ib619/Group7_design_project/Energy_Subsystem/Integration with Control/notes.md

# How to rearrange test files

1. Script for testing battery charge and discharge, with power source connected
2. Script for testing battery charging with PV panels (KEY AIM)
3. Script for testing PV discharge to batteries
4. Script for testing battery discharge to load
