ib619/Group7_design_project/Command_Subsystem/README.md

# Command Subsystem

## Folder Structure
```
Command_Subsystem
│   └───README.md
│   └───server               
│   |   └───authen       
|   |   |   |   └───mosquitto.conf  
|   |   |   |   |   ...
|   |   └───database.py
|   |   └───mqtt_server.py
|   |   └───requirements.txt
|   |   └───start_server.sh
|   |   |   ... 
|   └───client  
|   |   └───package.json
|   |   └───src  
|   |   |   └───assets
|   |   |   |   └───home.svg
|   |   |   |   |   ...
|   |   |   └───components
|   |   |   |   └───Battery.js
|   |   |   |   |   ...
|   |   |   └───hooks
|   |   |   |   └───useToken.js
|   |   |   |   |   ...
|   |   |   └───pages
|   |   |   |   └───DiscretePage.js
|   |   |   |   |   ...
|   |   |   └───App.js
|   |   |   └───index.js
|   |   |   |   ...            
```
## How to setup up the MQTT broker locally (without authentication)
- If you're running MQTT broker on AWS you can skip this step
1. Install the mosquitto broker using your local package manager
2. In the `mosquitto.conf` file, add the following lines:

```
listener 1883
protocol mqtt
listener 8080
protocol websockets

allow_anonymous true
```
4. On mac, the config file is located at `/usr/local/etc/mosquitto/mosquitto.conf`
5. To start the local mosquitto broker with the config file run: `/usr/local/sbin/mosquitto -c /usr/local/etc/mosquitto/mosquitto.conf -v`
    - [path to mosquitto exe] -c [path to config file]

## How to run the frontend (react)
1. Install npm using your local package manager 
2. Run `npm install` to install all the required dependencies in the `client` directory
3. To start the web app `npm start`
    - This will start the development build for the client (react app)

## How to run production build (frontend)
1. `npm run build` to create `build` folder
2. `serve -s build` to view the webpage on your local network

## How to run the backend (python)
1. In the `server` directory, run `pip3 install -r requirements.txt`
2. To create the `.db` file, run `python3 database.py` in the `server` directory (this is only if you haven't already created the database)
3. To run the backend server, run `python3 mqtt_server.py` in the `server` directory
4. Can also run the script `./start_server.sh` in the `server` directory to set up the database and server
    - `chmod +x start_server.sh` first

## How to set up AWS server 
1. Create EC2 Ubuntu Server and open the following ports:
    - Custom TCP 8080 (Used for websockets with React, May not need to open this if React is on EC2 itself)
    - Cusom TCP 1883 (Used for MQTT)
    - SSH 22
2. Specify "Anywhere" for the Source so that connections can be made anywhere
3. After downloading the key-pair, run `chmod og-rwx [path to .pem file]` to change permissions
4. To ssh into the instance, run `ssh -i [path to key-pair] ubuntu@[ip address of server]
5. To setup the stuff, in the root directory
```
sudo apt update
[ clone the git repo ]
cd Group7_design_project/Command_Subsystem/server
sudo curl -sSL https://get.docker.com/ | sh
```
6. Then run `sudo docker build . -t mars_server:1.0 --file Dockerfile` (also run this whenever the Dockerfile changes)
7. Run this command to start up the docker image and link docker ports to server ports
`sudo docker run -it --rm -p 0.0.0.0:1883:1883 -p 0.0.0.0:8080:8080/tcp mars_server:1.0`

## How to use the webpage 
1. On the Login page, enter the IP address of your MQTT broker, followed by a username and password pair.
    - If not using AWS server (Ubuntu), can be any username and password
    - If using AWS server, the list of valid usernames and passwords are shown below
    - At any point in time, only 1 user of a certain username and password pair can be connected to the web interface

Username | Password| Permissions
--- | --- | ---
admin | marsrover | full access
siting | password | read access 
siyu | password | read access 
igor | password | read access 
joshua | password | read access 
tah | password | read access 
yanni | password | read access 

2. On the home page, clicking on any of the links on the navigation bar will bring you to another page.
3. Clicking on the battery icon will create a pop-up screen that displays more in-depth information about the individual cells.
4. Scrolling and panning can be done on the map but only to a certain extent
5. After logging in once, login details will be saved and you won't be prompted to log in again
6. If you wish to change any of the log in details, use the `Log Out` button to return to the Login page
### Details
1. Things to send back to ESP32
    - drive/discrete: discrete mode instructions 
    - drive/t2c: t2c mode instructions
    - reset: reset rover to 0,0 / emergency stop
    - battery/recalibrate: tell battery to recalibrate

2. Things to receive from ESP32:
    - position/update: rover's current position
    - obstacle/result: 5 most recent obtsacle data
    - rover/status: rover status / remaining range
    - battery/status: battery soh / soc / state
    - path: past positions to map out path taken by rover
    - rssi: signal strength

3. Backend/Database:
    - Backend database using SQLite hosted on AWS using Docker containers
    - MQTT protocol for communication between ESP32, backend and frontend
    - obstacle/update: stream of detected obstacle position, keeps track of recent ones and stores in a db
    - position/update: stores positions in a db to be sent on path 

## Testing Procedure
### Testing the server
1. In the `server` folder, run `python3 mqtt_server.py` then run `python3 test_mqtt_server.py` in a separate terminal
2. Check the test script terminal for outputs to make sure the result is as expected

### Testing the database 
1. Run `python3 test_database.py` and check the terminal outputs to ensure that the results are correct
