ib619/Group7_design_project/Energy_Subsystem/Drive_Data/drivepwr.jpg

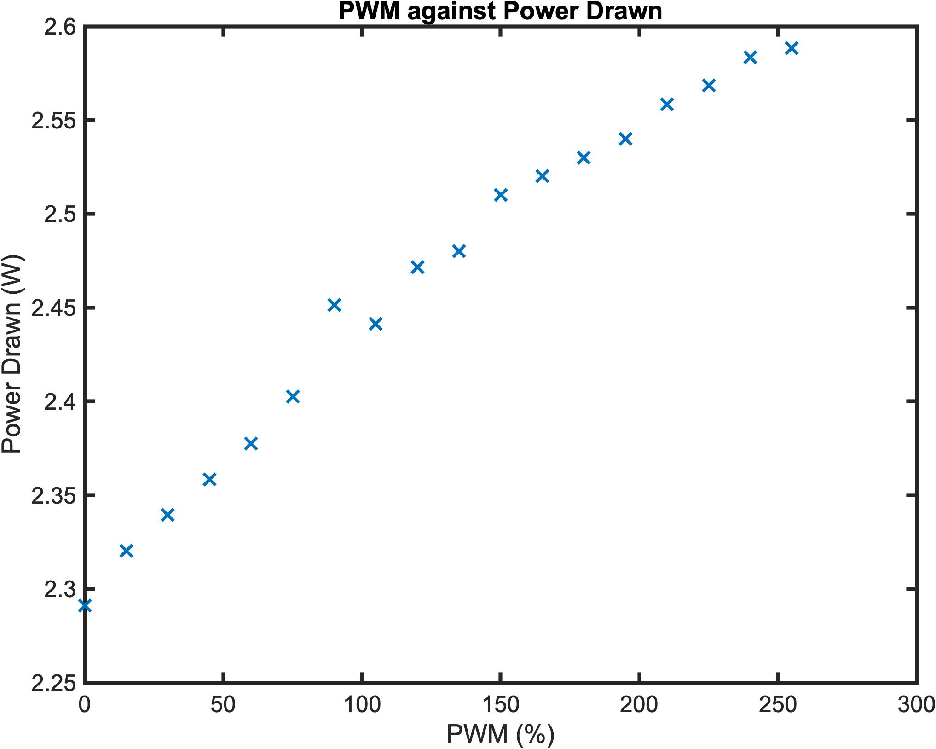
Energy_Subsystem/Drive_Data/drivepwr.jpg
