ib619/Group7_design_project/Energy_Subsystem/Images/Cell Balancing.png

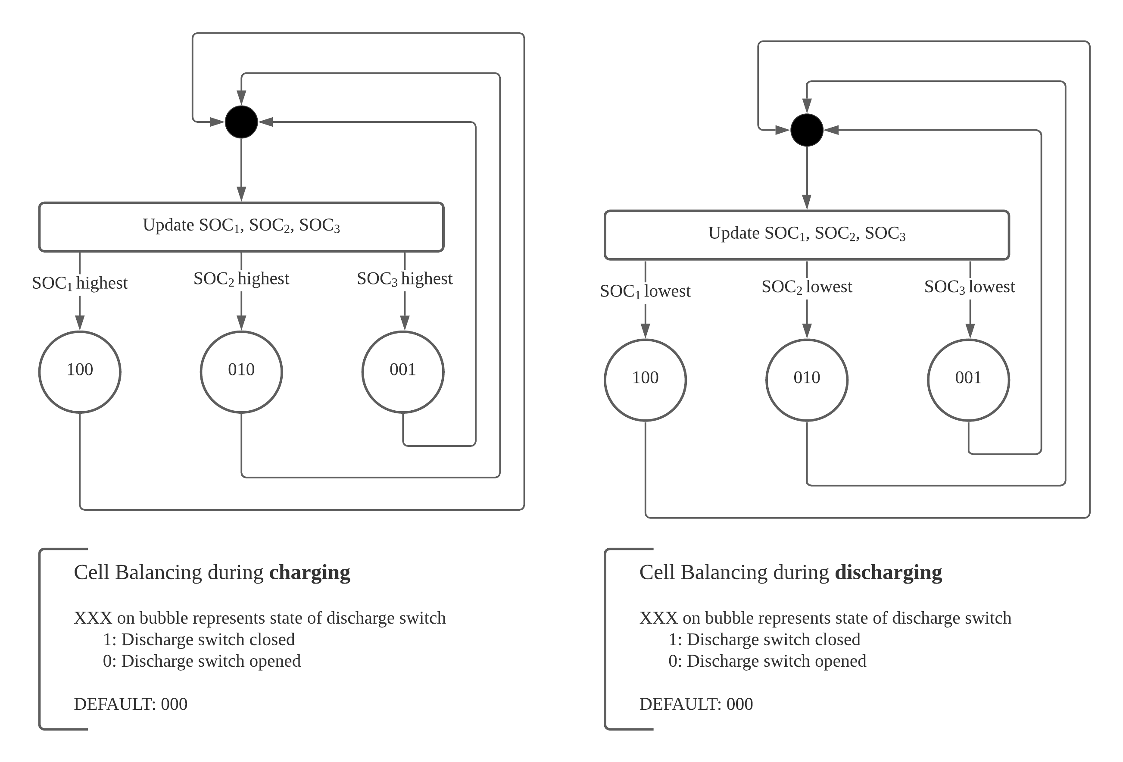
Energy_Subsystem/Images/Cell Balancing.png
