ib619/Group7_design_project/Energy_Subsystem/Images/cv_curve.jpg

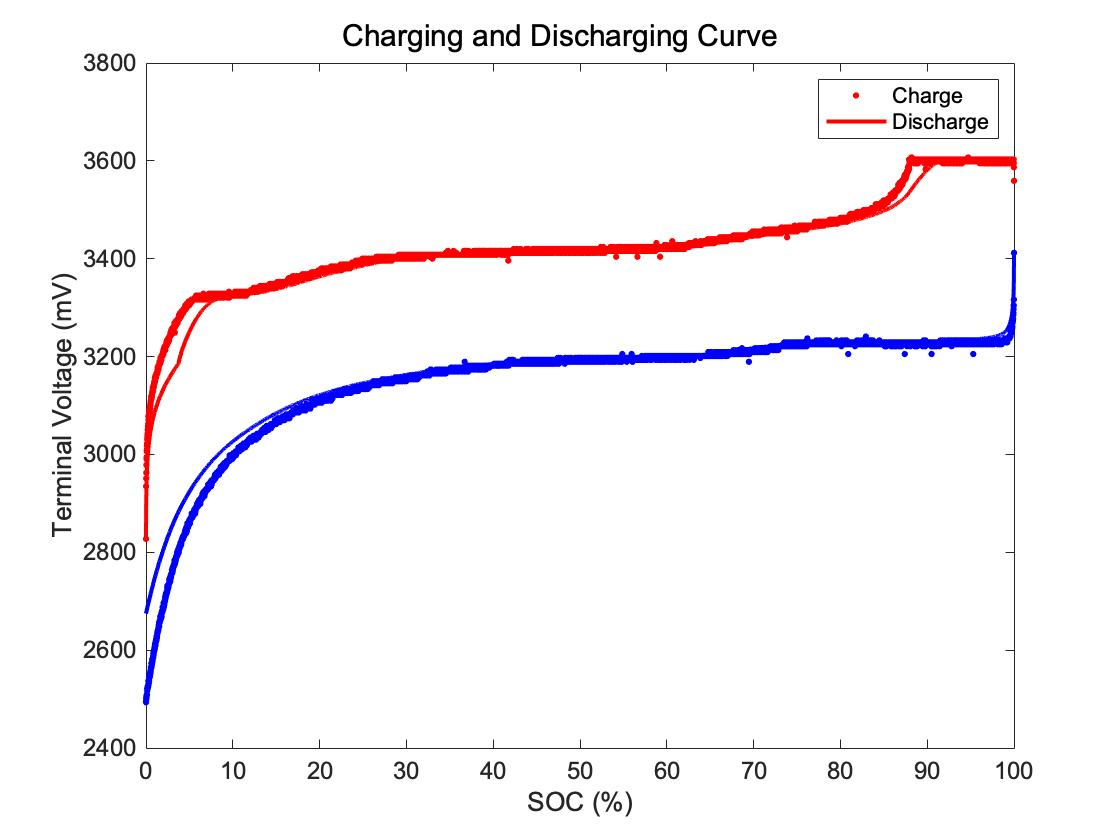
Energy_Subsystem/Images/cv_curve.jpg
