ib619/Group7_design_project/Energy_Subsystem/Images/Energy State Diagram.png

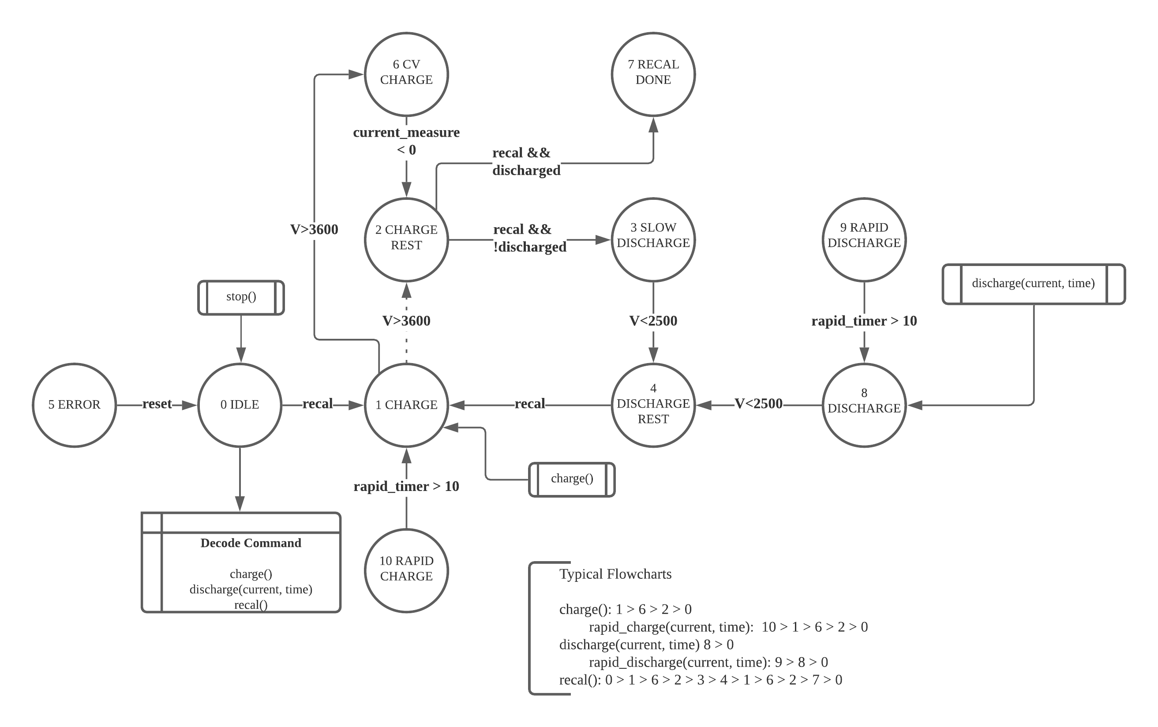
Energy_Subsystem/Images/Energy State Diagram.png
