ib619/Group7_design_project/Energy_Subsystem/Images/IC_Increment_Comparison.jpg

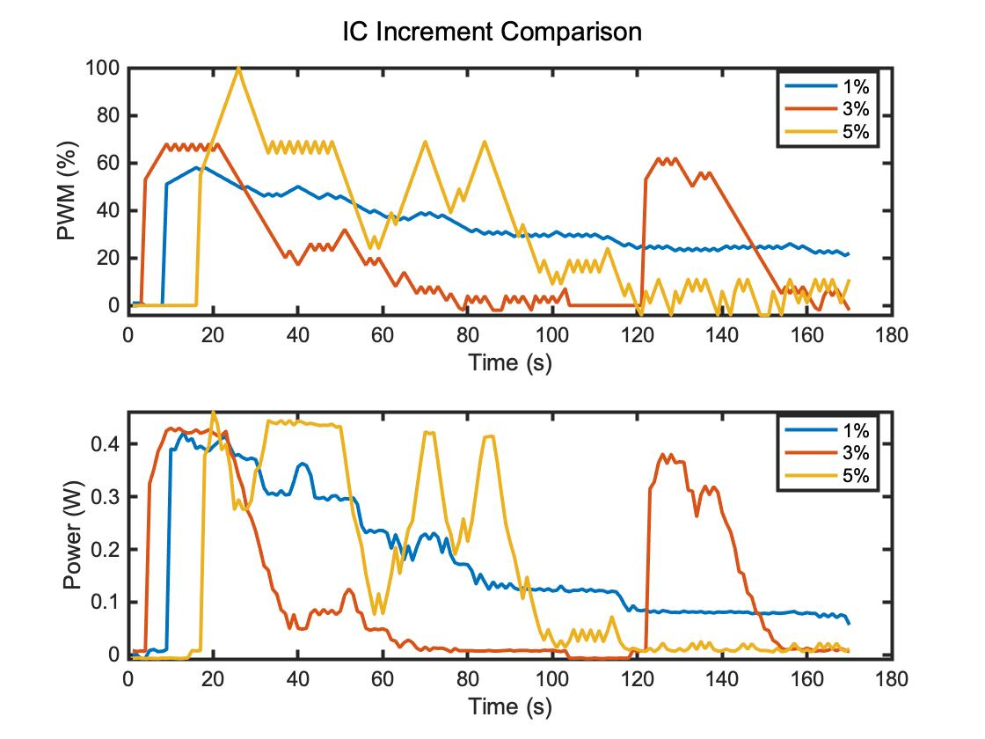
Energy_Subsystem/Images/IC_Increment_Comparison.jpg
