ib619/Group7_design_project/Energy_Subsystem/Images/PnO.png

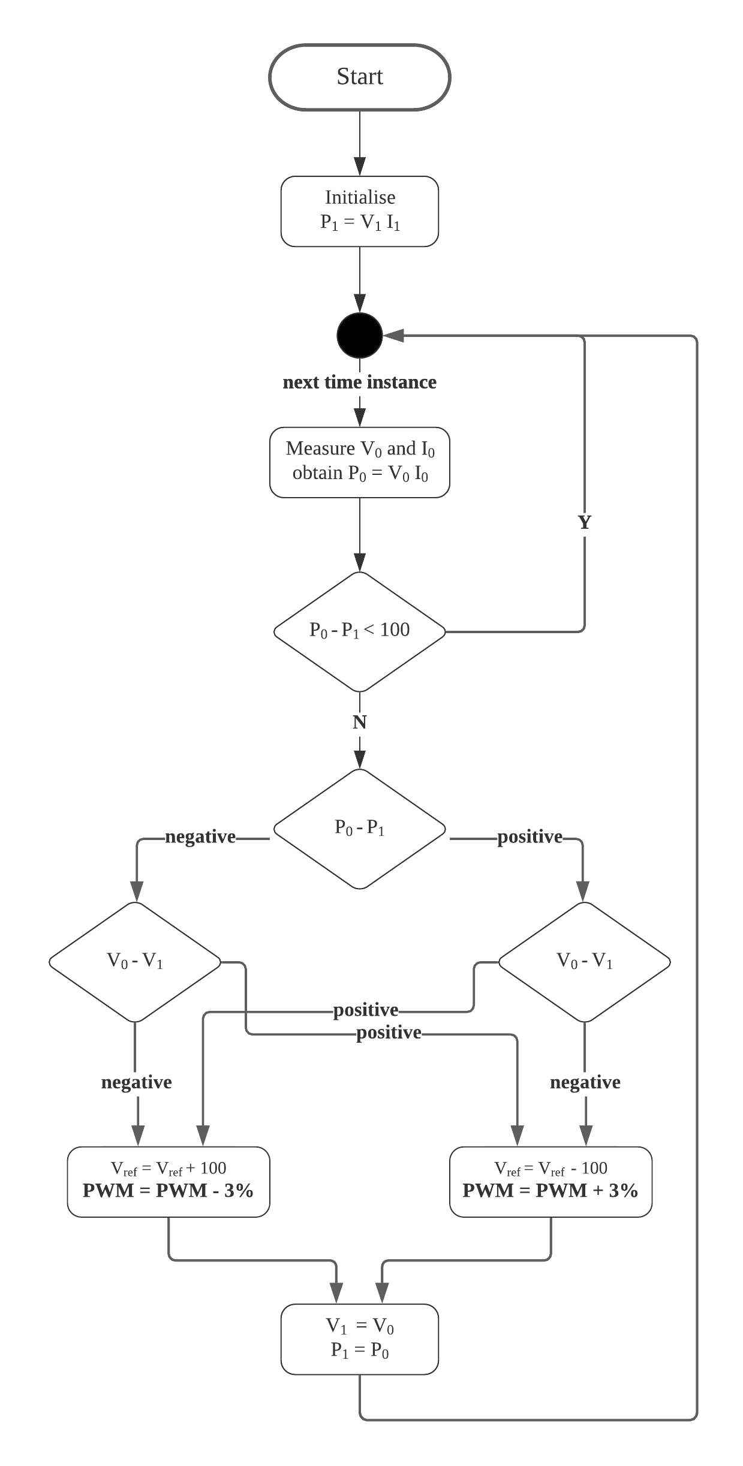
Energy_Subsystem/Images/PnO.png
