ib619/Group7_design_project/Energy_Subsystem/Images/PV_1_PWM.jpg

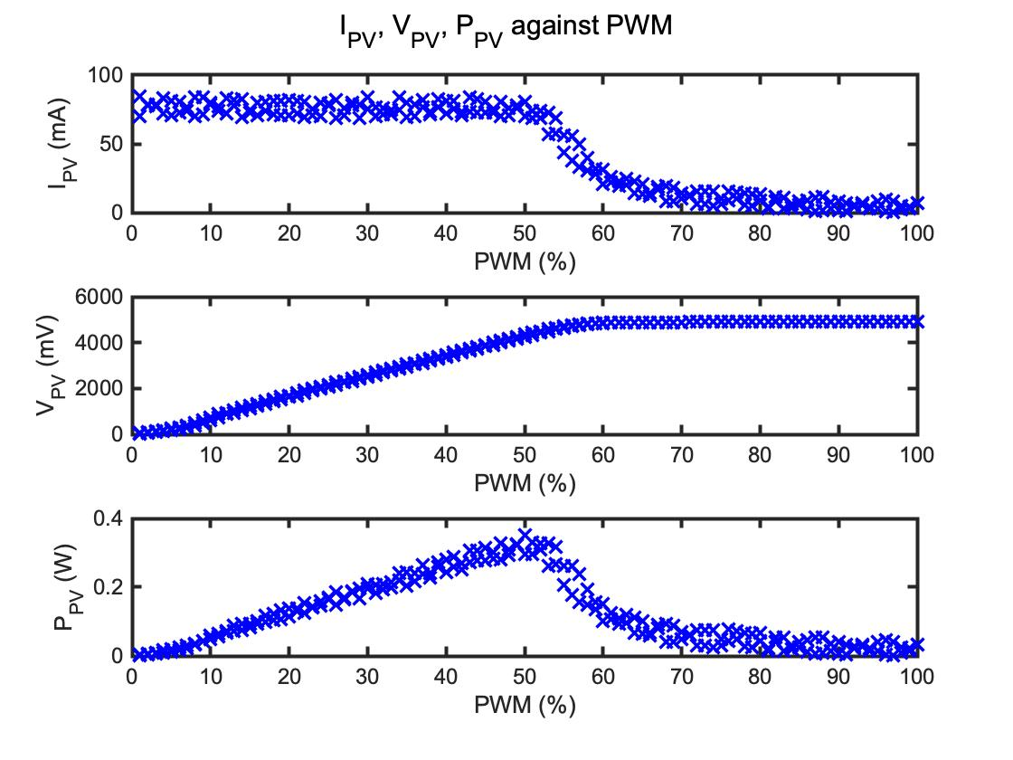
Energy_Subsystem/Images/PV_1_PWM.jpg
