ib619/Group7_design_project/Energy_Subsystem/Images/SoC Estimation Algorithm.png

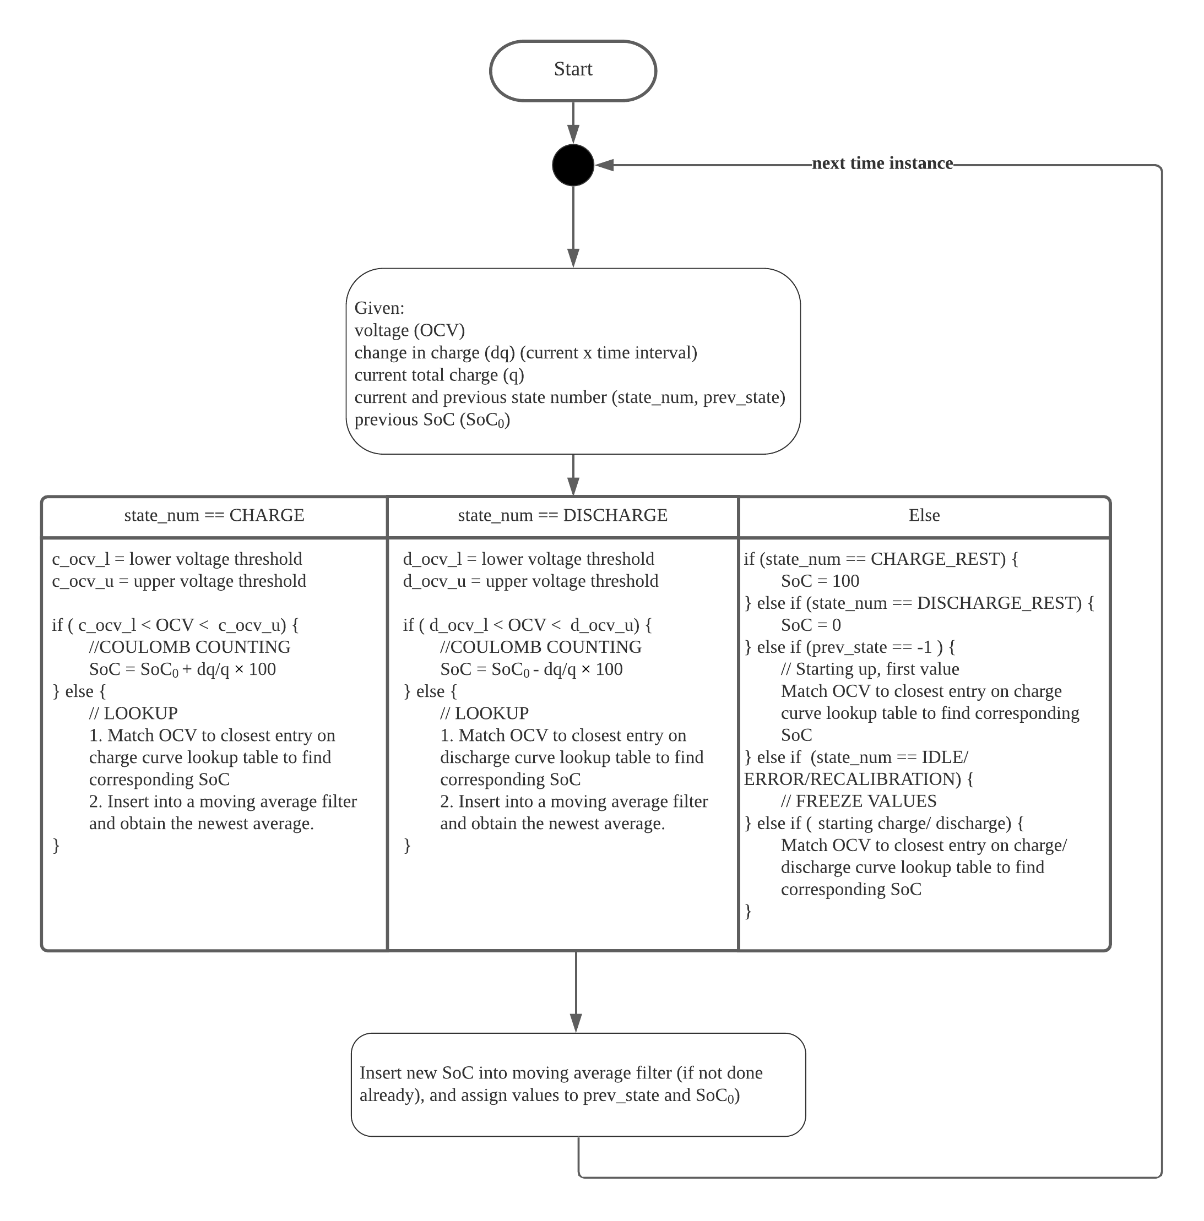
Energy_Subsystem/Images/SoC Estimation Algorithm.png
