ib619/Group7_design_project/Energy_Subsystem/Images/wall_discharge_SoC_ideal.jpg

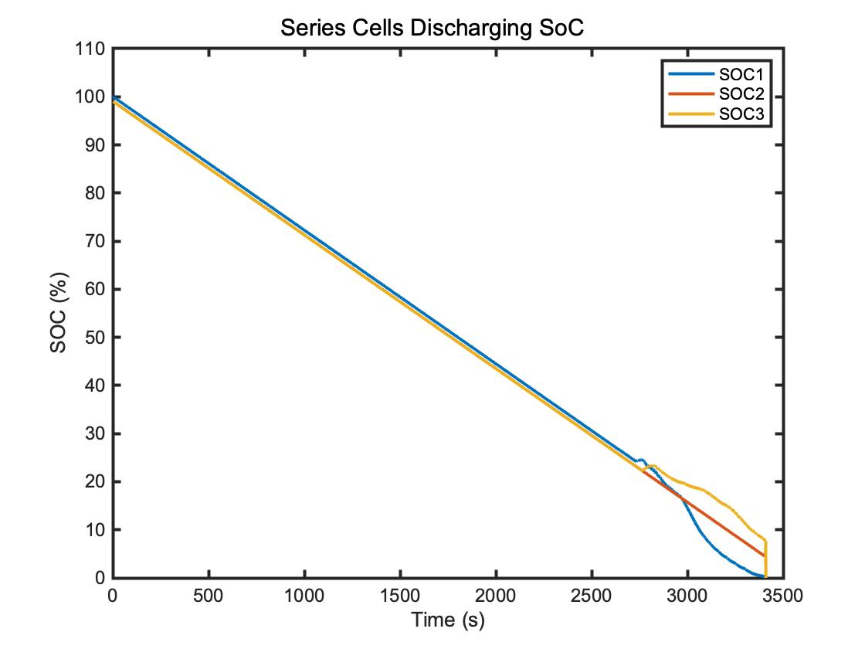
Energy_Subsystem/Images/wall_discharge_SoC_ideal.jpg
