ib619/Group7_design_project/(list of files, cad)

Other CAD files:
Vision_Subsystem/DE10_LITE_D8M_VIP_16/stp1.stp
