ib619/Group7_design_project/Energy_Subsystem/Test Scripts/Wall_Charge/Test1/serial1.rtf

Initializing SD card...
Wiring is correct and a card is present.
3380.19,3392.12,3384.17,100.00
3252.94,3256.92,3248.96,98.99
3252.94,3244.99,3248.96,97.98
3248.96,3244.99,3244.99,96.97
3248.96,3244.99,3244.99,95.96
3248.96,3244.99,3248.96,94.95
3244.99,3244.99,3244.99,93.94
3244.99,3244.99,3244.99,92.93
3248.96,3241.01,3244.99,91.92
3248.96,3241.01,3244.99,90.91
3244.99,3241.01,3244.99,89.90
3244.99,3241.01,3244.99,88.89
3241.01,3241.01,3244.99,87.88
3244.99,3241.01,3241.01,86.87
3241.01,3241.01,3241.01,85.86
3241.01,3237.03,3241.01,84.85
3241.01,3237.03,3237.03,83.84
3241.01,3237.03,3241.01,82.83
3237.03,3237.03,3237.03,81.82
3233.06,3229.08,3237.03,80.81
3229.08,3229.08,3237.03,79.80
3225.10,3233.06,3229.08,78.79
3225.10,3233.06,3233.06,77.78
3221.13,3229.08,3225.10,76.77
3221.13,3229.08,3225.10,75.76
3221.13,3225.10,3221.13,74.75
3217.15,3221.13,3221.13,73.74
3213.17,3221.13,3221.13,72.73
3213.17,3217.15,3217.15,71.72
3217.15,3217.15,3217.15,70.71
3217.15,3213.17,3209.20,69.70
3217.15,3213.17,3209.20,68.69
3213.17,3205.22,3213.17,67.68
3217.15,3209.20,3209.20,66.67
3217.15,3205.22,3209.20,65.66
3217.15,3201.24,3209.20,64.65
3217.15,3209.20,3209.20,63.64
3217.15,3201.24,3205.22,62.63
3213.17,3201.24,3209.20,61.62
3217.15,3201.24,3209.20,60.61
3217.15,3201.24,3213.17,59.60
3213.17,3197.27,3205.22,58.59
3213.17,3197.27,3205.22,57.58
3213.17,3197.27,3205.22,56.57
3213.17,3197.27,3205.22,55.56
3209.20,3189.31,3197.27,54.55
3209.20,3197.27,3201.24,53.54
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
Looked up charge table
Not moving average
1,3356.33,3328.50,3304.64,24.24,1.15,6.16,1793.00,2000.50,1921.75
1,3356.33,3328.50,3304.64,-490.00,-488.40,1,0,1
Looked up charge table
Not moving average
1,3352.36,3328.50,3304.64,21.21,1.13,6.14,1793.00,2000.50,1921.75
1,3352.36,3328.50,3304.64,-490.00,-491.60,1,0,1
Looked up charge table
Not moving average
1,3352.36,3328.50,3304.64,21.21,1.10,6.11,1793.00,2000.50,1921.75
1,3352.36,3328.50,3304.64,-490.00,-559.70,1,0,1
Looked up charge table
Not moving average
1,3352.36,3328.50,3304.64,21.21,1.08,6.08,1793.00,2000.50,1921.75
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
