ib619/Group7_design_project/Vision_Subsystem/testing/gaussian_filter/db/gaussian_filter_tb.lpc.html

Hierarchy | Input | Constant Input | Unused Input | Floating Input | Output | Constant Output | Unused Output | Floating Output | Bidir | Constant Bidir | Unused Bidir | Input only Bidir | Output only Bidir
lbuff3|ALTSHIFT_TAPS_component|auto_generated|cntr3 | 4 | 0 | 0 | 0 | 1 | 0 | 0 | 0 | 0 | 0 | 0 | 0 | 0
lbuff3|ALTSHIFT_TAPS_component|auto_generated|cntr1|cmpr7 | 6 | 0 | 0 | 0 | 1 | 0 | 0 | 0 | 0 | 0 | 0 | 0 | 0
lbuff3|ALTSHIFT_TAPS_component|auto_generated|cntr1 | 2 | 0 | 0 | 0 | 3 | 0 | 0 | 0 | 0 | 0 | 0 | 0 | 0
lbuff3|ALTSHIFT_TAPS_component|auto_generated|altsyncram2 | 42 | 1 | 0 | 1 | 32 | 1 | 1 | 1 | 0 | 0 | 0 | 0 | 0
lbuff3|ALTSHIFT_TAPS_component|auto_generated | 11 | 0 | 0 | 0 | 40 | 0 | 0 | 0 | 0 | 0 | 0 | 0 | 0
lbuff3 | 11 | 0 | 0 | 0 | 40 | 0 | 0 | 0 | 0 | 0 | 0 | 0 | 0
