ib619/Group7_design_project/Vision_Subsystem/testing/morph_filter/dilation/db/dilation_filter_tb.lpc.html

Hierarchy | Input | Constant Input | Unused Input | Floating Input | Output | Constant Output | Unused Output | Floating Output | Bidir | Constant Bidir | Unused Bidir | Input only Bidir | Output only Bidir
lbuff|ALTSHIFT_TAPS_component|auto_generated|cntr3 | 4 | 0 | 0 | 0 | 1 | 0 | 0 | 0 | 0 | 0 | 0 | 0 | 0
lbuff|ALTSHIFT_TAPS_component|auto_generated|cntr1|cmpr7 | 6 | 0 | 0 | 0 | 1 | 0 | 0 | 0 | 0 | 0 | 0 | 0 | 0
lbuff|ALTSHIFT_TAPS_component|auto_generated|cntr1 | 2 | 0 | 0 | 0 | 3 | 0 | 0 | 0 | 0 | 0 | 0 | 0 | 0
lbuff|ALTSHIFT_TAPS_component|auto_generated|altsyncram2 | 12 | 1 | 0 | 1 | 2 | 1 | 1 | 1 | 0 | 0 | 0 | 0 | 0
lbuff|ALTSHIFT_TAPS_component|auto_generated | 4 | 0 | 0 | 0 | 3 | 0 | 0 | 0 | 0 | 0 | 0 | 0 | 0
lbuff | 4 | 0 | 0 | 0 | 2 | 0 | 0 | 0 | 0 | 0 | 0 | 0 | 0
