ib619/Group7_design_project/Vision_Subsystem/testing/colour_threshold/rgb_to_hsv_tb/db/rgb_to_hsv_tb.lpc.html

Hierarchy | Input | Constant Input | Unused Input | Floating Input | Output | Constant Output | Unused Output | Floating Output | Bidir | Constant Bidir | Unused Bidir | Input only Bidir | Output only Bidir
divide_s|LPM_DIVIDE_component|auto_generated|divider|divider|add_sub_1 | 4 | 0 | 0 | 0 | 3 | 0 | 0 | 0 | 0 | 0 | 0 | 0 | 0
divide_s|LPM_DIVIDE_component|auto_generated|divider|divider|add_sub_0 | 2 | 0 | 0 | 0 | 2 | 0 | 0 | 0 | 0 | 0 | 0 | 0 | 0
divide_s|LPM_DIVIDE_component|auto_generated|divider|divider | 27 | 0 | 0 | 0 | 24 | 0 | 0 | 0 | 0 | 0 | 0 | 0 | 0
divide_s|LPM_DIVIDE_component|auto_generated|divider | 27 | 0 | 0 | 0 | 24 | 0 | 0 | 0 | 0 | 0 | 0 | 0 | 0
divide_s|LPM_DIVIDE_component|auto_generated | 27 | 0 | 0 | 0 | 24 | 0 | 0 | 0 | 0 | 0 | 0 | 0 | 0
divide_s | 27 | 8 | 0 | 8 | 16 | 8 | 8 | 8 | 0 | 0 | 0 | 0 | 0
divide_h|LPM_DIVIDE_component|auto_generated|divider|divider|add_sub_1 | 4 | 0 | 0 | 0 | 3 | 0 | 0 | 0 | 0 | 0 | 0 | 0 | 0
divide_h|LPM_DIVIDE_component|auto_generated|divider|divider|add_sub_0 | 2 | 0 | 0 | 0 | 2 | 0 | 0 | 0 | 0 | 0 | 0 | 0 | 0
divide_h|LPM_DIVIDE_component|auto_generated|divider|divider | 25 | 0 | 0 | 0 | 30 | 0 | 0 | 0 | 0 | 0 | 0 | 0 | 0
divide_h|LPM_DIVIDE_component|auto_generated|divider | 25 | 0 | 0 | 0 | 22 | 0 | 0 | 0 | 0 | 0 | 0 | 0 | 0
divide_h|LPM_DIVIDE_component|auto_generated | 25 | 0 | 0 | 0 | 22 | 0 | 0 | 0 | 0 | 0 | 0 | 0 | 0
divide_h | 25 | 0 | 0 | 0 | 14 | 0 | 0 | 0 | 0 | 0 | 0 | 0 | 0
