ib619/Group7_design_project/Vision_Subsystem/testing/perspective_transform/perspective_transform_tb/db/perspective_transform_tb.lpc.html

Hierarchy | Input | Constant Input | Unused Input | Floating Input | Output | Constant Output | Unused Output | Floating Output | Bidir | Constant Bidir | Unused Bidir | Input only Bidir | Output only Bidir
dy|LPM_DIVIDE_component|auto_generated|divider|divider|add_sub_1 | 4 | 0 | 0 | 0 | 3 | 0 | 0 | 0 | 0 | 0 | 0 | 0 | 0
dy|LPM_DIVIDE_component|auto_generated|divider|divider|add_sub_0 | 2 | 0 | 0 | 0 | 2 | 0 | 0 | 0 | 0 | 0 | 0 | 0 | 0
dy|LPM_DIVIDE_component|auto_generated|divider|divider | 58 | 0 | 0 | 0 | 84 | 0 | 0 | 0 | 0 | 0 | 0 | 0 | 0
dy|LPM_DIVIDE_component|auto_generated|divider | 58 | 0 | 0 | 0 | 56 | 0 | 0 | 0 | 0 | 0 | 0 | 0 | 0
dy|LPM_DIVIDE_component|auto_generated | 58 | 0 | 0 | 0 | 56 | 0 | 0 | 0 | 0 | 0 | 0 | 0 | 0
dy | 58 | 0 | 0 | 0 | 28 | 0 | 0 | 0 | 0 | 0 | 0 | 0 | 0
dx|LPM_DIVIDE_component|auto_generated|divider|divider|add_sub_1 | 4 | 0 | 0 | 0 | 3 | 0 | 0 | 0 | 0 | 0 | 0 | 0 | 0
dx|LPM_DIVIDE_component|auto_generated|divider|divider|add_sub_0 | 2 | 0 | 0 | 0 | 2 | 0 | 0 | 0 | 0 | 0 | 0 | 0 | 0
dx|LPM_DIVIDE_component|auto_generated|divider|divider | 58 | 0 | 0 | 0 | 84 | 0 | 0 | 0 | 0 | 0 | 0 | 0 | 0
dx|LPM_DIVIDE_component|auto_generated|divider | 58 | 0 | 0 | 0 | 56 | 0 | 0 | 0 | 0 | 0 | 0 | 0 | 0
dx|LPM_DIVIDE_component|auto_generated | 58 | 0 | 0 | 0 | 56 | 0 | 0 | 0 | 0 | 0 | 0 | 0 | 0
dx | 58 | 0 | 0 | 0 | 28 | 0 | 0 | 0 | 0 | 0 | 0 | 0 | 0
