ib619/Group7_design_project/Drive_Subsystem/test_setup.png

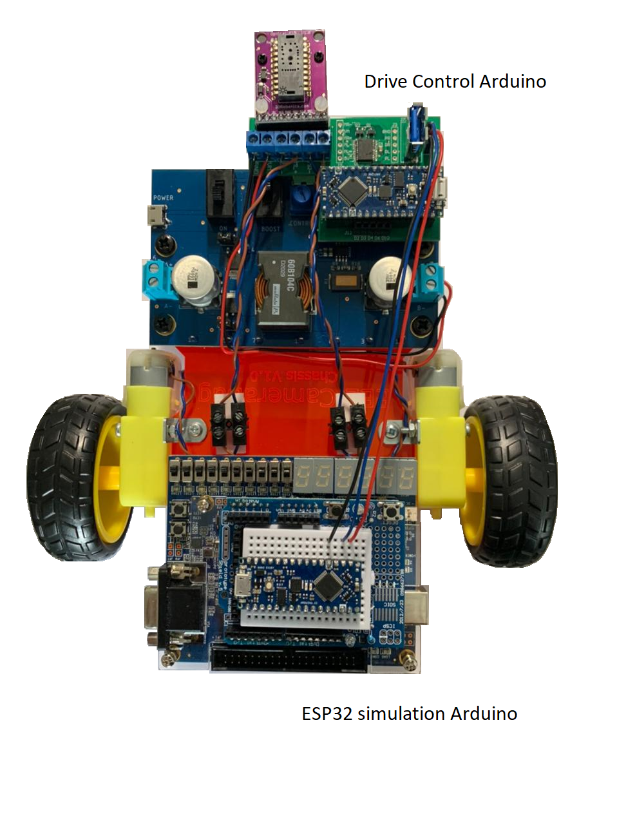
Drive_Subsystem/test_setup.png
