ib619/Group7_design_project/Energy_Subsystem/Images/cv_characteristic.jpg

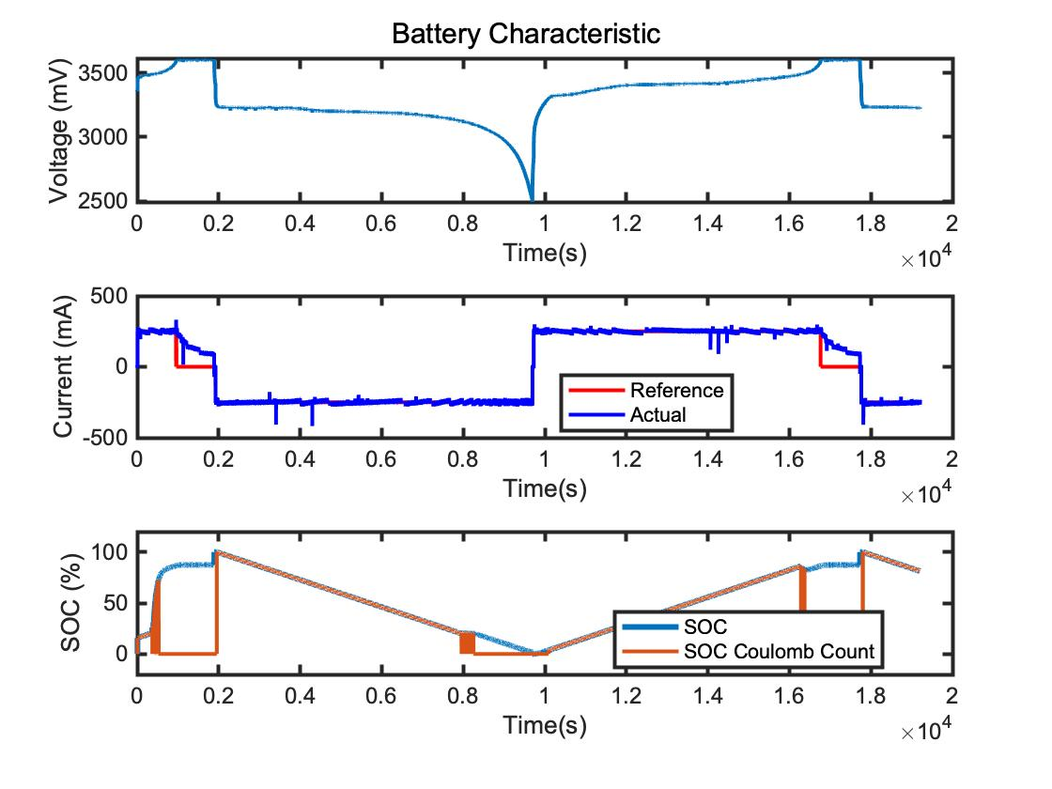
Energy_Subsystem/Images/cv_characteristic.jpg
