ib619/Group7_design_project/Energy_Subsystem/Images/normal_characteristic.jpg

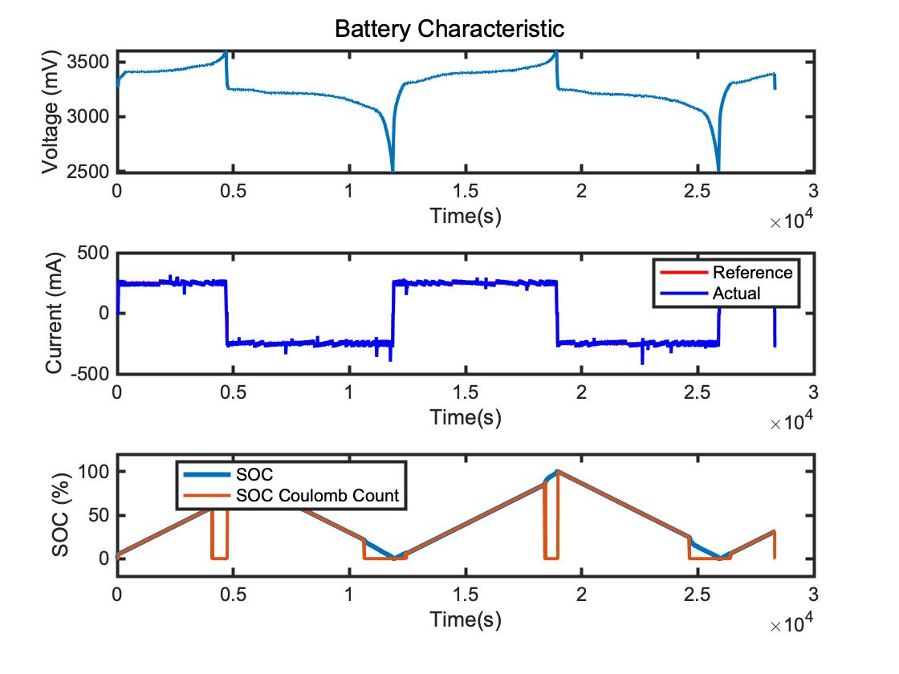
Energy_Subsystem/Images/normal_characteristic.jpg
