ib619/Group7_design_project/Energy_Subsystem/Images/wall_discharge_characteristic.jpg

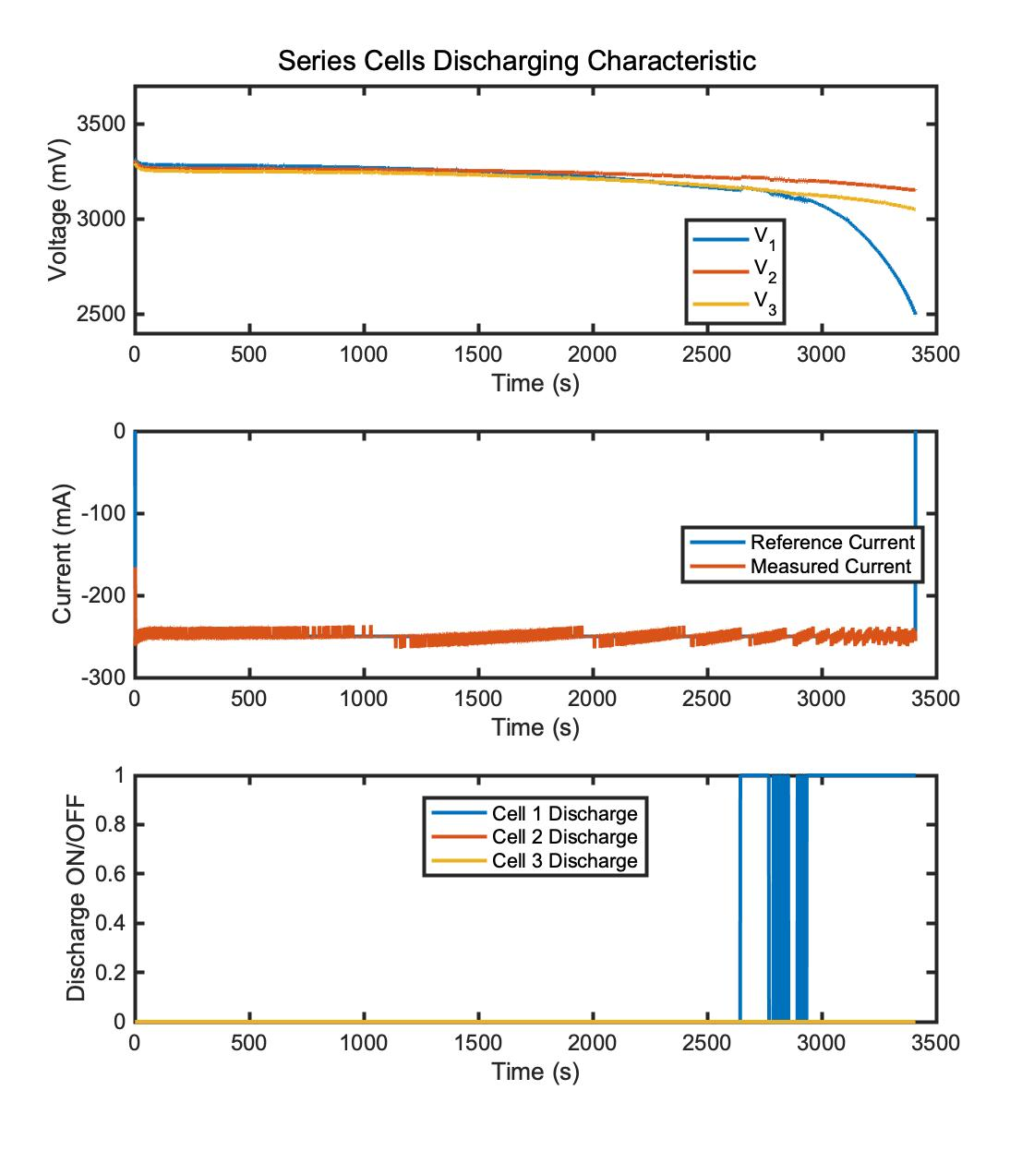
Energy_Subsystem/Images/wall_discharge_characteristic.jpg
