ib619/Group7_design_project/Energy_Subsystem/Initial Battery Discharge Profiles/cellcharacteristic2.jpg

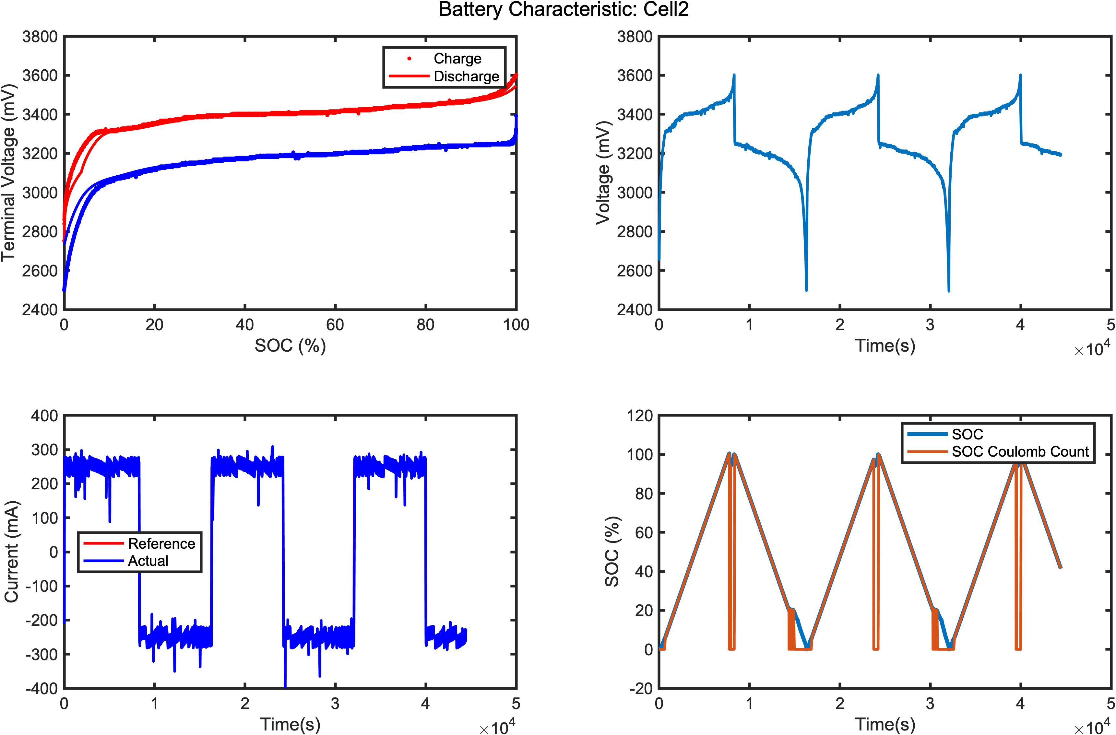
Energy_Subsystem/Initial Battery Discharge Profiles/cellcharacteristic2.jpg
