ib619/Group7_design_project/Energy_Subsystem/Test Scripts/PnO_Sweep_Duty/draft.jpg

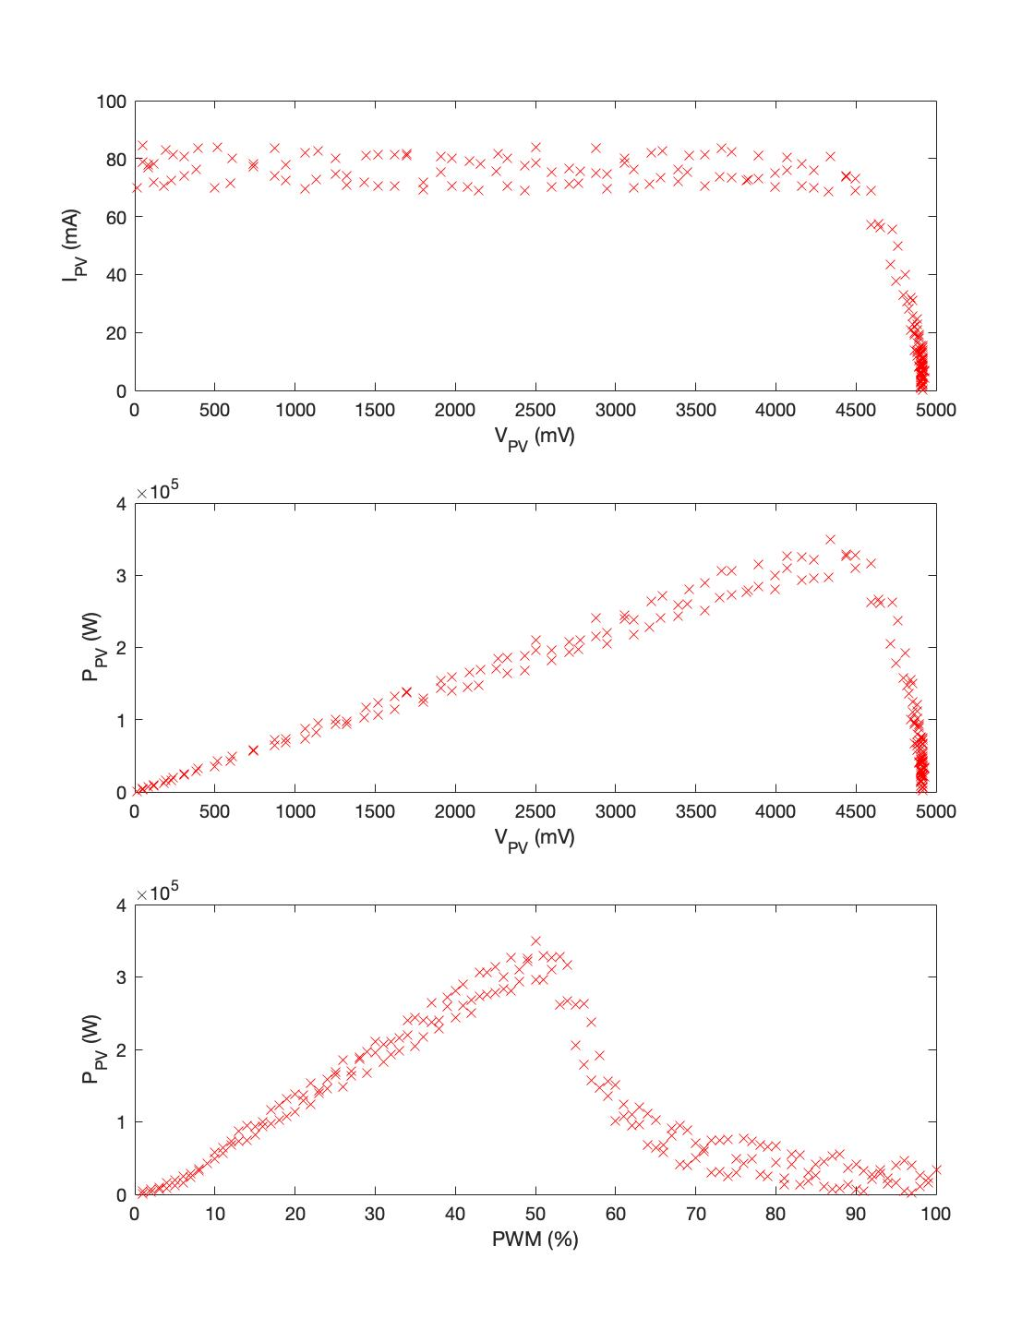
Energy_Subsystem/Test Scripts/PnO_Sweep_Duty/draft.jpg
