ib619/Group7_design_project/Vision_Subsystem/testing/colour_threshold/rgb_to_hsv_waveform.jpg

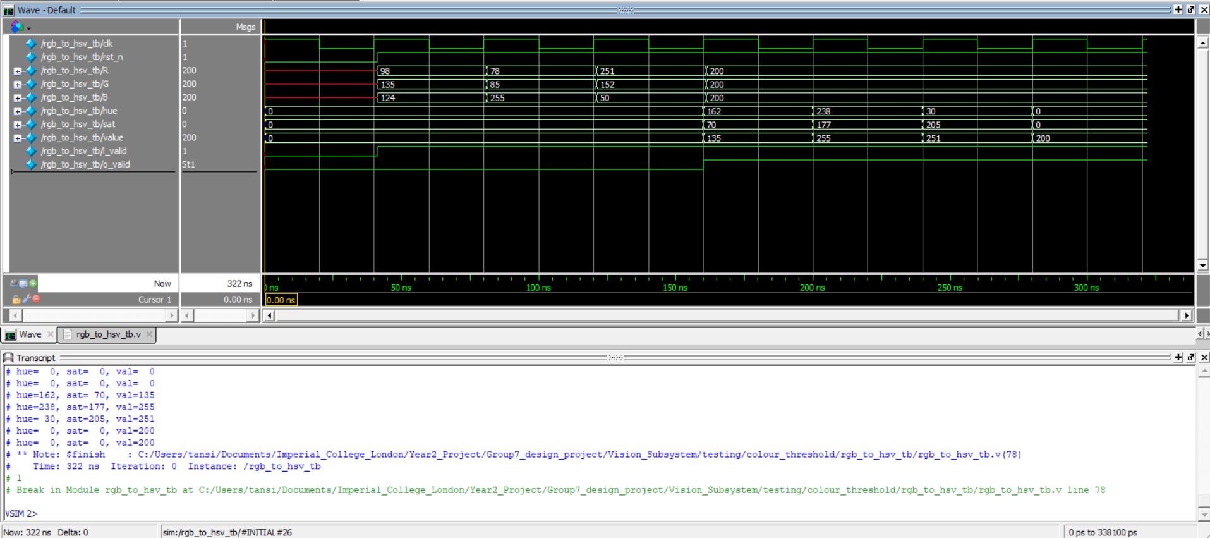
Vision_Subsystem/testing/colour_threshold/rgb_to_hsv_waveform.jpg
