ib619/Group7_design_project/Vision_Subsystem/testing/gaussian_filter/gaussian_filter_waveform.jpg

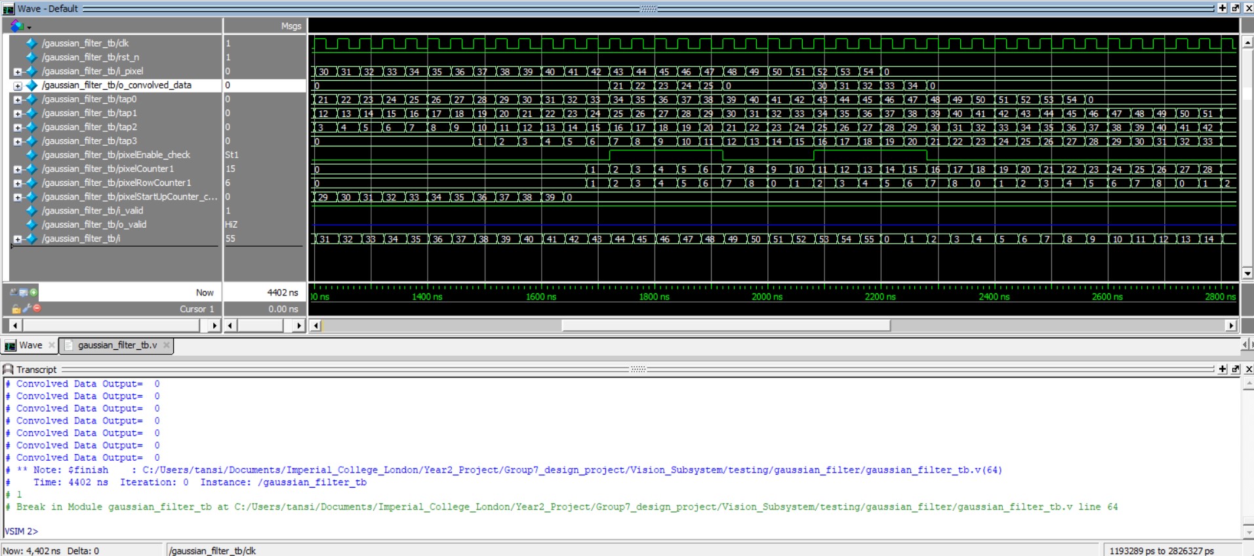
Vision_Subsystem/testing/gaussian_filter/gaussian_filter_waveform.jpg
