ib619/Group7_design_project/Vision_Subsystem/testing/hsv_hist/Hsv_Hist_exposure2000_gain380.png

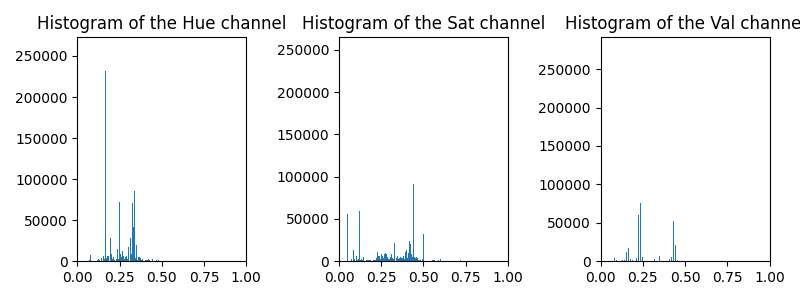
Vision_Subsystem/testing/hsv_hist/Hsv_Hist_exposure2000_gain380.png
