ib619/Group7_design_project/Vision_Subsystem/testing/images/blue_gain380.jpg

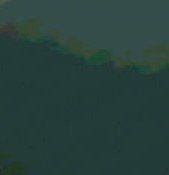
Vision_Subsystem/testing/images/blue_gain380.jpg
