ib619/Group7_design_project/Vision_Subsystem/testing/images/grey_edge.jpg

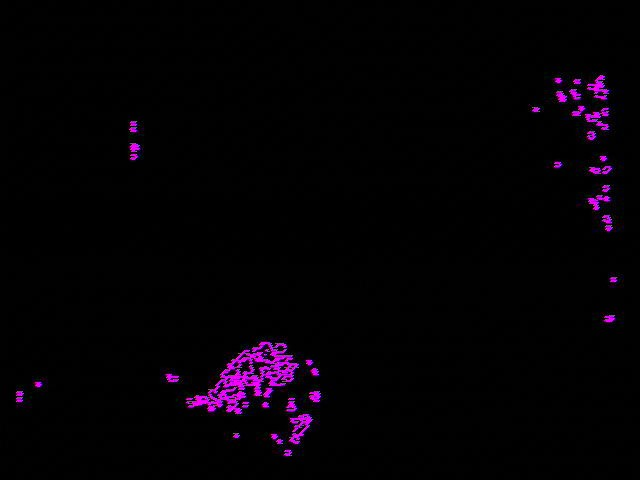
Vision_Subsystem/testing/images/grey_edge.jpg
