ib619/Group7_design_project/Vision_Subsystem/testing/images/grey_gain780.jpg

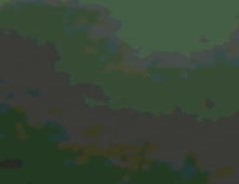
Vision_Subsystem/testing/images/grey_gain780.jpg
