ib619/Group7_design_project/Vision_Subsystem/testing/images/perspective.jpg

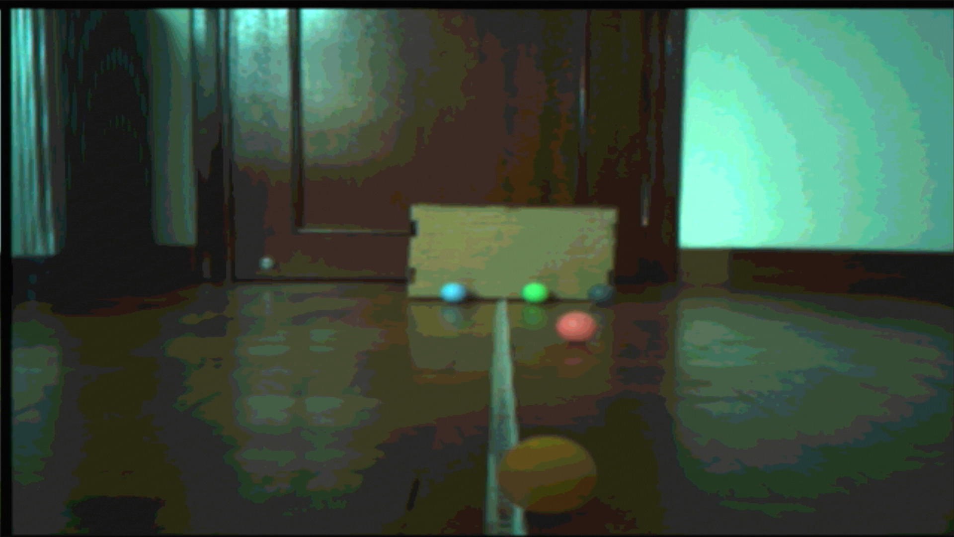
Vision_Subsystem/testing/images/perspective.jpg
