ib619/Group7_design_project/Vision_Subsystem/testing/images/pink_gain380.jpg

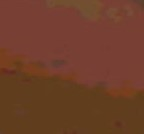
Vision_Subsystem/testing/images/pink_gain380.jpg
