ib619/Group7_design_project/Vision_Subsystem/testing/images/red_ball.jpg

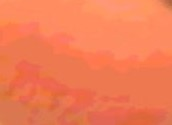
Vision_Subsystem/testing/images/red_ball.jpg
