ib619/Group7_design_project/Vision_Subsystem/testing/images/test_img780.jpg

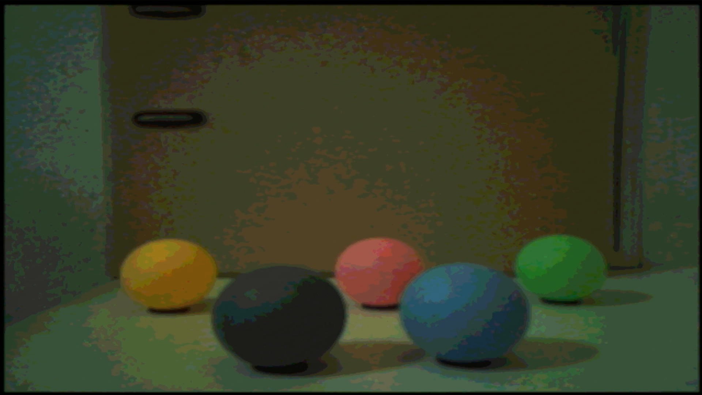
Vision_Subsystem/testing/images/test_img780.jpg
