ib619/Group7_design_project/Vision_Subsystem/testing/images/testing.jpg

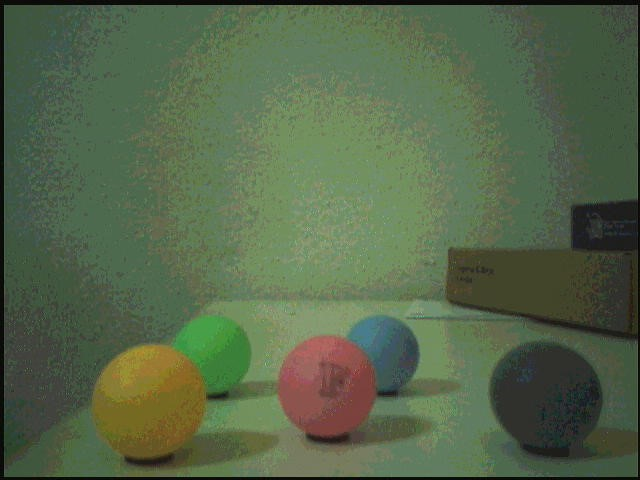
Vision_Subsystem/testing/images/testing.jpg
