ib619/Group7_design_project/Vision_Subsystem/testing/images/tuning_grey.jpg

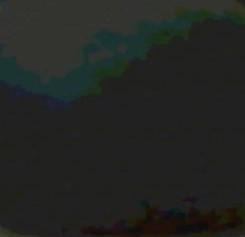
Vision_Subsystem/testing/images/tuning_grey.jpg
