ib619/Group7_design_project/Vision_Subsystem/testing/morph_filter/dilation/Dilation_waveform.jpg

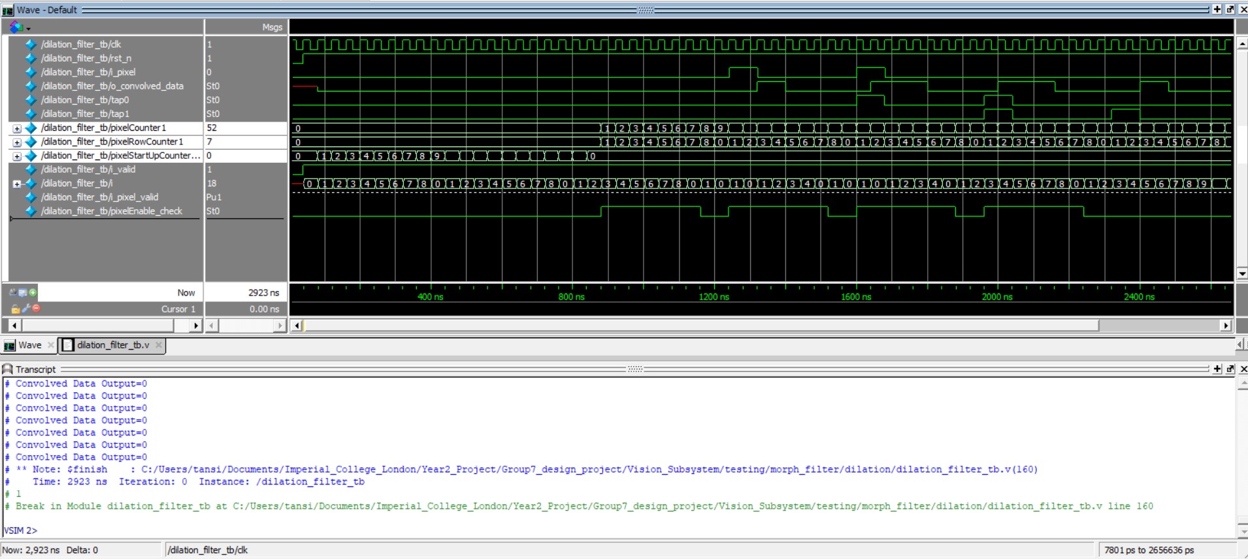
Vision_Subsystem/testing/morph_filter/dilation/Dilation_waveform.jpg
