ib619/Group7_design_project/Vision_Subsystem/testing/morph_filter/erosion/Erosion_waveform.jpg

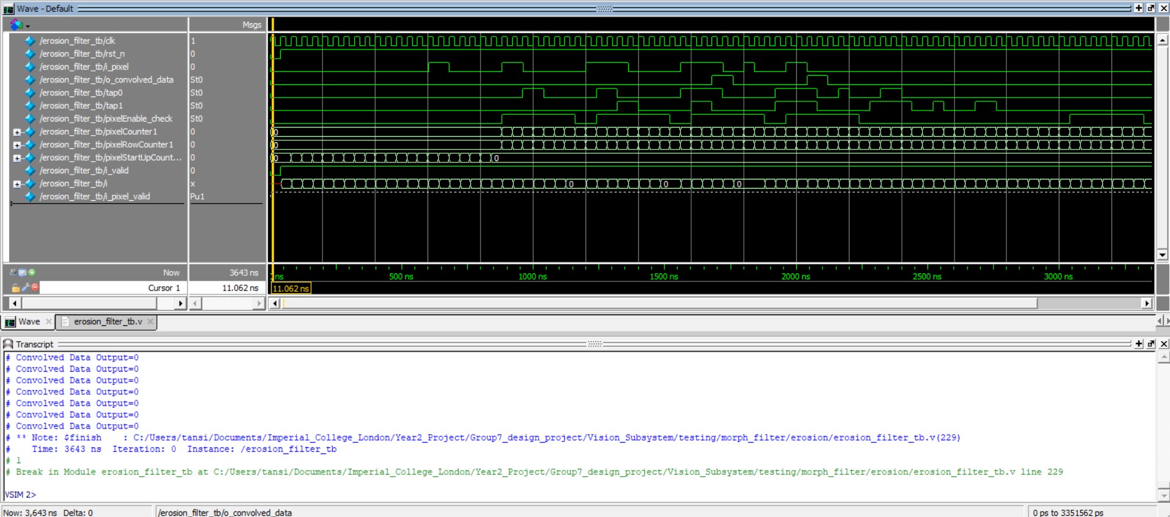
Vision_Subsystem/testing/morph_filter/erosion/Erosion_waveform.jpg
