ib619/Group7_design_project/Vision_Subsystem/testing/perspective_transform/perspective_transform_waveform.jpg

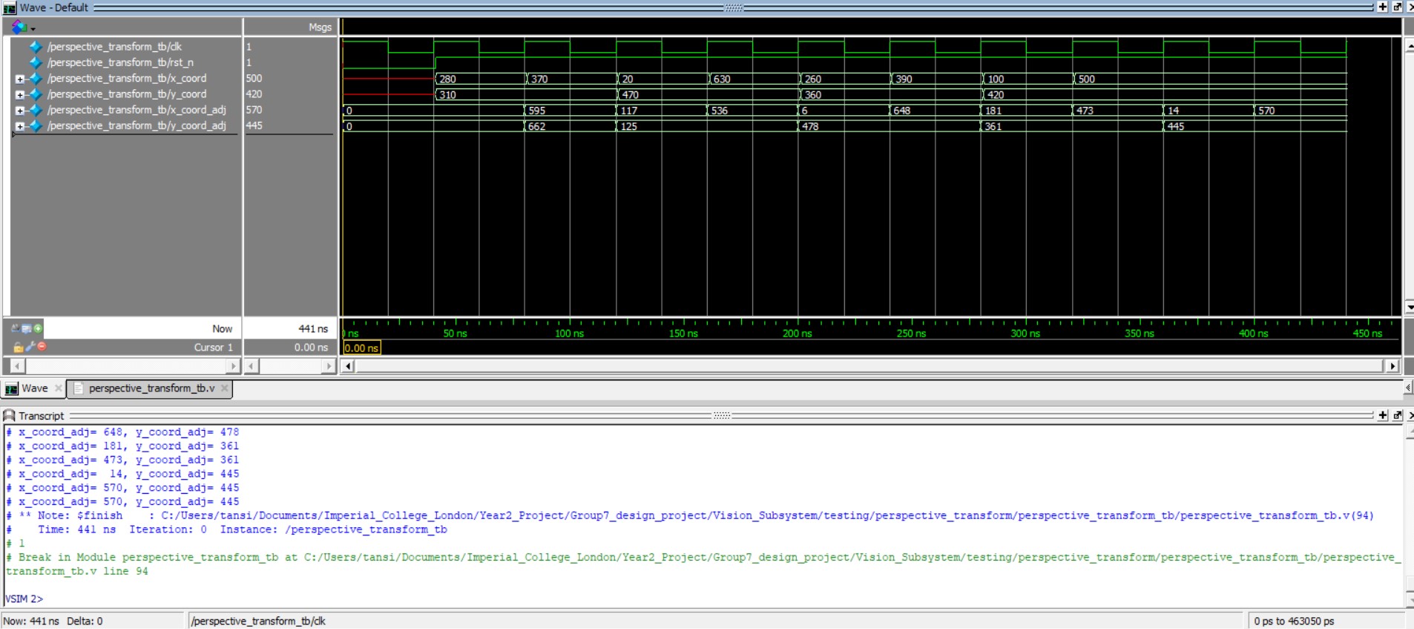
Vision_Subsystem/testing/perspective_transform/perspective_transform_waveform.jpg
