ib619/Group7_design_project/Drive_Subsystem/Arduino_Code/Drive_Control_integration.ino

//including necessary libraries

#include "ControlInterface.h"
#include <Drive.h>
#include <Orientation.h>
#include "SPI.h"
#include <Wire.h>
#include <INA219_WE.h>

//defining pin names
#define PIN_SS        10
#define PIN_MISO      12
#define PIN_MOSI      11
#define PIN_SCK       13

#define PIN_MOUSECAM_RESET     8
#define PIN_MOUSECAM_CS        7

//defining constants

#define ADNS3080_PIXELS_X                 30
#define ADNS3080_PIXELS_Y                 30

#define ADNS3080_PRODUCT_ID            0x00
#define ADNS3080_REVISION_ID           0x01
#define ADNS3080_MOTION                0x02
#define ADNS3080_DELTA_X               0x03
#define ADNS3080_DELTA_Y               0x04
#define ADNS3080_SQUAL                 0x05
#define ADNS3080_PIXEL_SUM             0x06
#define ADNS3080_MAXIMUM_PIXEL         0x07
#define ADNS3080_CONFIGURATION_BITS    0x0a
#define ADNS3080_EXTENDED_CONFIG       0x0b
#define ADNS3080_DATA_OUT_LOWER        0x0c
#define ADNS3080_DATA_OUT_UPPER        0x0d
#define ADNS3080_SHUTTER_LOWER         0x0e
#define ADNS3080_SHUTTER_UPPER         0x0f
#define ADNS3080_FRAME_PERIOD_LOWER    0x10
#define ADNS3080_FRAME_PERIOD_UPPER    0x11
#define ADNS3080_MOTION_CLEAR          0x12
#define ADNS3080_FRAME_CAPTURE         0x13
#define ADNS3080_SROM_ENABLE           0x14
#define ADNS3080_FRAME_PERIOD_MAX_BOUND_LOWER      0x19
#define ADNS3080_FRAME_PERIOD_MAX_BOUND_UPPER      0x1a
#define ADNS3080_FRAME_PERIOD_MIN_BOUND_LOWER      0x1b
#define ADNS3080_FRAME_PERIOD_MIN_BOUND_UPPER      0x1c
#define ADNS3080_SHUTTER_MAX_BOUND_LOWER           0x1e
#define ADNS3080_SHUTTER_MAX_BOUND_UPPER           0x1e
#define ADNS3080_SROM_ID               0x1f
#define ADNS3080_OBSERVATION           0x3d
#define ADNS3080_INVERSE_PRODUCT_ID    0x3f
#define ADNS3080_PIXEL_BURST           0x40
#define ADNS3080_MOTION_BURST          0x50
#define ADNS3080_SROM_LOAD             0x60

#define ADNS3080_PRODUCT_ID_VAL        0x17


//initialising orientation variables

Orientation myOrientation;
RightMotor myRightMotor;
LeftMotor myLeftMotor;
Rover marsRover;

ControlInterface ci(&Serial1);
int direction_value=0;
int speed_value=0;
int distance_value=0;
int drive_mode = 0;
int targetX = 0;
int targetY = 0;

unsigned long period_time = 500;
unsigned long send_timer;

//initialising motor sketch variables


INA219_WE ina219; // this is the instantiation of the library for the current sensor

float open_loop, closed_loop; // Duty Cycles
float vpd,vb,vref,iL,dutyref,current_mA; // Measurement Variables
unsigned int sensorValue0,sensorValue1,sensorValue2,sensorValue3;  // ADC sample values declaration
float ev=0,cv=0,ei=0,oc=0; //internal signals
float Ts=0.0008; //1.25 kHz control frequency. It's better to design the control period as integral multiple of switching period.
float kpv=0.05024,kiv=15.78,kdv=0; // voltage pid.
float u0v,u1v,delta_uv,e0v,e1v,e2v; // u->output; e->error; 0->this time; 1->last time; 2->last last time
float kpi=0.02512,kii=39.4,kdi=0; // current pid.
float u0i,u1i,delta_ui,e0i,e1i,e2i; // Internal values for the current controller
float uv_max=4, uv_min=0; //anti-windup limitation
float ui_max=1, ui_min=0; //anti-windup limitation
float current_limit = 1.0;
boolean Boost_mode = 0;
boolean CL_mode = 0;


unsigned int loopTrigger;
unsigned int com_count=0;   // a variables to count the interrupts. Used for program debugging.

//*******************************************************************//

//initialising optical sensor sketch variables

long total_x = 0;
long total_y = 0;

long total_x1 = 0;
long total_y1 = 0;

int x=0;
int y=0;

int a=0;
int b=0;

int distance_x=0;
int distance_y=0;

int tdistance = 0;

volatile byte movementflag=0;
volatile int xydat[2];

byte frame[ADNS3080_PIXELS_X * ADNS3080_PIXELS_Y];


//declaring optical sensor sketch functions

int convTwosComp(int b){
  //Convert from 2's complement
  if(b & 0x80){
    b = -1 * ((b ^ 0xff) + 1);
    }
  return b;
  }


void mousecam_reset()
{
  digitalWrite(PIN_MOUSECAM_RESET,HIGH);
  delay(1); // reset pulse >10us
  digitalWrite(PIN_MOUSECAM_RESET,LOW);
  delay(35); // 35ms from reset to functional
}


int mousecam_init()
{
  pinMode(PIN_MOUSECAM_RESET,OUTPUT);
  pinMode(PIN_MOUSECAM_CS,OUTPUT);
  
  digitalWrite(PIN_MOUSECAM_CS,HIGH);
  
  mousecam_reset();
  
  int pid = mousecam_read_reg(ADNS3080_PRODUCT_ID);
  if(pid != ADNS3080_PRODUCT_ID_VAL)
    return -1;

  // turn on sensitive mode
  mousecam_write_reg(ADNS3080_CONFIGURATION_BITS, 0x19);

  return 0;
}

void mousecam_write_reg(int reg, int val)
{
  digitalWrite(PIN_MOUSECAM_CS, LOW);
  SPI.transfer(reg | 0x80);
  SPI.transfer(val);
  digitalWrite(PIN_MOUSECAM_CS,HIGH);
  delayMicroseconds(50);
}

int mousecam_read_reg(int reg)
{
  digitalWrite(PIN_MOUSECAM_CS, LOW);
  SPI.transfer(reg);
  delayMicroseconds(75);
  int ret = SPI.transfer(0xff);
  digitalWrite(PIN_MOUSECAM_CS,HIGH); 
  delayMicroseconds(1);
  return ret;
}

struct MD
{
 byte motion;
 char dx, dy;
 byte squal;
 word shutter;
 byte max_pix;
};


void mousecam_read_motion(struct MD *p)
{
  digitalWrite(PIN_MOUSECAM_CS, LOW);
  SPI.transfer(ADNS3080_MOTION_BURST);
  delayMicroseconds(75);
  p->motion =  SPI.transfer(0xff);
  p->dx =  SPI.transfer(0xff);
  p->dy =  SPI.transfer(0xff);
  p->squal =  SPI.transfer(0xff);
  p->shutter =  SPI.transfer(0xff)<<8;
  p->shutter |=  SPI.transfer(0xff);
  p->max_pix =  SPI.transfer(0xff);
  digitalWrite(PIN_MOUSECAM_CS,HIGH); 
  delayMicroseconds(5);
}

// pdata must point to an array of size ADNS3080_PIXELS_X x ADNS3080_PIXELS_Y
// you must call mousecam_reset() after this if you want to go back to normal operation
int mousecam_frame_capture(byte *pdata)
{
  mousecam_write_reg(ADNS3080_FRAME_CAPTURE,0x83);
  
  digitalWrite(PIN_MOUSECAM_CS, LOW);
  
  SPI.transfer(ADNS3080_PIXEL_BURST);
  delayMicroseconds(50);
  
  int pix;
  byte started = 0;
  int count;
  int timeout = 0;
  int ret = 0;
  for(count = 0; count < ADNS3080_PIXELS_X * ADNS3080_PIXELS_Y; )
  {
    pix = SPI.transfer(0xff);
    delayMicroseconds(10);
    if(started==0)
    {
      if(pix&0x40)
        started = 1;
      else
      {
        timeout++;
        if(timeout==100)
        {
          ret = -1;
          break;
        }
      }
    }
    if(started==1)
    {
      pdata[count++] = (pix & 0x3f)<<2; // scale to normal grayscale byte range
    }
  }

  digitalWrite(PIN_MOUSECAM_CS,HIGH); 
  delayMicroseconds(14);
  
  return ret;
}

char asciiart(int k)
{
  static char foo[] = "WX86*3I>!;~:,`. ";
  return foo[k>>4];
}


void setup() {
//motor sketch setup routine

  myLeftMotor.init(20, 9);
  myRightMotor.init(21, 5);
  marsRover.init(&myLeftMotor, &myRightMotor);
  marsRover.enablePID = 0;
  send_timer = millis();


  //Basic pin setups
  
  noInterrupts(); //disable all interrupts
  pinMode(3, INPUT_PULLUP); //Pin3 is the input from the Buck/Boost switch
  pinMode(2, INPUT_PULLUP); // Pin 2 is the input from the CL/OL switch
  analogReference(EXTERNAL); // We are using an external analogue reference for the ADC

  // TimerA0 initialization for control-loop interrupt.
  
  TCA0.SINGLE.PER = 255; //
  TCA0.SINGLE.CMP1 = 255; //
  TCA0.SINGLE.CTRLA = TCA_SINGLE_CLKSEL_DIV64_gc | TCA_SINGLE_ENABLE_bm; //64 prescaler, 1M.
  TCA0.SINGLE.INTCTRL = TCA_SINGLE_CMP1_bm; 

  // TimerB0 initialization for PWM output
  
  pinMode(6, OUTPUT);
  TCB0.CTRLA=TCB_CLKSEL_CLKDIV1_gc | TCB_ENABLE_bm; //62.5kHz
  analogWrite(6,120); 

  interrupts();  //enable interrupts.
  Wire.begin(); // We need this for the i2c comms for the current sensor
  ina219.init(); // this initiates the current sensor
  Wire.setClock(700000); // set the comms speed for i2c
  

//optical flow sensor sketch setup routine

  pinMode(PIN_SS,OUTPUT);
  pinMode(PIN_MISO,INPUT);
  pinMode(PIN_MOSI,OUTPUT);
  pinMode(PIN_SCK,OUTPUT);
  
  SPI.begin();
  SPI.setClockDivider(SPI_CLOCK_DIV32);
  SPI.setDataMode(SPI_MODE3);
  SPI.setBitOrder(MSBFIRST);
  
  Serial.begin(19200);

  if(mousecam_init()==-1)
  {
    Serial.println("Mouse cam failed to init");
    while(1);
  } 

  ci.setBaudrate(19200);
  ci.setTimeout(5);
  ci.begin();
  delay(3000);
  ci.flushReadBuffer();
}


void loop() {
//command reception loop

  if(ci.fetchData())  {
    direction_value=ci.getDirection();  //fetch new direction value
    speed_value=ci.getSpeed();  //fetch new speed value
    distance_value=ci.getDistance();  // fetch new distance value
    drive_mode = ci.getDriveMode(); //fetch new drive mode value
    targetX = ci.getTargetX();
    targetY = ci.getTargetY();

    myOrientation.resetData(ci.getReset());

    Serial.println("Command Received");
    Serial.println("Drive Mode: " + String(drive_mode));
    Serial.println("Distance: " + String(distance_value));
    Serial.println("Speed: " + String(speed_value));
    Serial.println("Direction: " + String(direction_value));
    Serial.println("Target X: " + String(targetX));
    Serial.println("Target Y: " + String(targetY) + "\n");

    marsRover.decodeCommand(drive_mode, distance_value, speed_value, direction_value);
    marsRover.decodeT2C(targetX, targetY, myOrientation.passPosX(), myOrientation.passPosY(), myOrientation.passDirX(), myOrientation.passDirY());
  }
  
//motor sketch loop

  unsigned long currentMillis = millis();
  if(loopTrigger) { // This loop is triggered, it wont run unless there is an interrupt
      
    // Sample all of the measurements and check which control mode we are in
    sampling();
    CL_mode = digitalRead(3); // input from the OL_CL switch
    Boost_mode = digitalRead(2); // input from the Buck_Boost switch

    if (Boost_mode){
      if (CL_mode) { //Closed Loop Boost
          pwm_modulate(1); // This disables the Boost as we are not using this mode
      }else{ // Open Loop Boost
          pwm_modulate(1); // This disables the Boost as we are not using this mode
      }
    }else{      
      if (CL_mode) { // Closed Loop Buck
          // The closed loop path has a voltage controller cascaded with a current controller. The voltage controller
          // creates a current demand based upon the voltage error. This demand is saturated to give current limiting.
          // The current loop then gives a duty cycle demand based upon the error between demanded current and measured
          // current
          current_limit = 3; // Buck has a higher current limit
          ev = vref - vb;  //voltage error at this time
          cv=pidv(ev);  //voltage pid
          cv=saturation(cv, current_limit, 0); //current demand saturation
          ei=cv-iL; //current error
          closed_loop=pidi(ei);  //current pid
          closed_loop=saturation(closed_loop,0.99,0.01);  //duty_cycle saturation
          pwm_modulate(closed_loop); //pwm modulation
      }else{ // Open Loop Buck
          current_limit = 3; // Buck has a higher current limit
          oc = iL-current_limit; // Calculate the difference between current measurement and current limit
          if ( oc > 0) {
            open_loop=open_loop-0.001; // We are above the current limit so less duty cycle
          } else {
            open_loop=open_loop+0.001; // We are below the current limit so more duty cycle
          }
          open_loop=saturation(open_loop,dutyref,0.02); // saturate the duty cycle at the reference or a min of 0.01
          pwm_modulate(open_loop); // and send it out
      }
    }
    // closed loop control path

    loopTrigger = 0;
  }

  
//optical flow sensor sketch loop    

  int val = mousecam_read_reg(ADNS3080_PIXEL_SUM);
  MD md;
  mousecam_read_motion(&md);

    distance_x = md.dx; //convTwosComp(md.dx);
    distance_y = md.dy; //convTwosComp(md.dy);

total_x1 = (total_x1 + distance_x);
total_y1 = (total_y1 + distance_y);

total_x = 10*total_x1/157; //Conversion from counts per inch to mm (400 counts per inch)
total_y = 10*total_y1/157; //Conversion from counts per inch to mm (400 counts per inch)

myOrientation.enableLog();
myOrientation.updatePosition(total_x, total_y,  marsRover.moveForward_flag, marsRover.moveBack_flag, marsRover.turnCW_flag, marsRover.turnACW_flag);
myOrientation.updateDirection();

if (myOrientation.position_changed){
  //Serial.println(myOrientation.exportDirectionAngle());
  //myOrientation.logOrientation();
  //myOrientation.logRotation();
  //Serial.println("Rover position: " + String(myOrientation.exportPositionX()) + ": " + String(myOrientation.exportPositionY()) + "\n");
}

marsRover.sampleTime((unsigned long)millis());
marsRover.sampleDirection(myOrientation.passDirX(), myOrientation.passDirY());

marsRover.action(myOrientation.getTravelDistance(), myOrientation.getDirectionChangeAngle());

if (millis()-send_timer >= period_time) {
  ci.writeRoverHeading(myOrientation.exportDirectionAngle());
  ci.writeAlert(marsRover.command_running);
  ci.writeAxisX(myOrientation.exportPositionX());
  ci.writeAxisY(myOrientation.exportPositionY());
  ci.writeTotalDistance(myOrientation.exportTotalRun());
  ci.sendUpdates(); //send new values to ESP32

  send_timer = millis();

    Serial.println("Data sent to ESP32");
    Serial.println("Heading: " + String(myOrientation.exportDirectionAngle()));
    Serial.println("Alert: " + String(marsRover.command_running));
    Serial.println("X: " + String(myOrientation.exportPositionX()));
    Serial.println("Y: " + String(myOrientation.exportPositionY()));
    Serial.println("Total Distance: " + String(myOrientation.exportTotalRun()) + "\n");
}

}


//declaring motor sketch functions

// Timer A CMP1 interrupt. Every 800us the program enters this interrupt. 
// This, clears the incoming interrupt flag and triggers the main loop.

ISR(TCA0_CMP1_vect){
  TCA0.SINGLE.INTFLAGS |= TCA_SINGLE_CMP1_bm; //clear interrupt flag
  loopTrigger = 1;
}

// This subroutine processes all of the analogue samples, creating the required values for the main loop

void sampling(){

  // Make the initial sampling operations for the circuit measurements
  
  sensorValue0 = analogRead(A0); //sample Vb
  sensorValue2 = analogRead(A2); //sample Vref
  sensorValue3 = analogRead(A3); //sample Vpd
  current_mA = ina219.getCurrent_mA(); // sample the inductor current (via the sensor chip)

  // Process the values so they are a bit more usable/readable
  // The analogRead process gives a value between 0 and 1023 
  // representing a voltage between 0 and the analogue reference which is 4.096V
  
  vb = sensorValue0 * (4.096 / 1023.0); // Convert the Vb sensor reading to volts
  vref = sensorValue2 * (4.096 / 1023.0); // Convert the Vref sensor reading to volts
  vpd = sensorValue3 * (4.096 / 1023.0); // Convert the Vpd sensor reading to volts

  // The inductor current is in mA from the sensor so we need to convert to amps.
  // We want to treat it as an input current in the Boost, so its also inverted
  // For open loop control the duty cycle reference is calculated from the sensor
  // differently from the Vref, this time scaled between zero and 1.
  // The boost duty cycle needs to be saturated with a 0.33 minimum to prevent high output voltages
  
  if (Boost_mode == 1){
    iL = -current_mA/1000.0;
    dutyref = saturation(sensorValue2 * (1.0 / 1023.0),0.99,0.33);
  }else{
    iL = current_mA/1000.0;
    dutyref = sensorValue2 * (1.0 / 1023.0);
  }
  
}

float saturation( float sat_input, float uplim, float lowlim){ // Saturatio function
  if (sat_input > uplim) sat_input=uplim;
  else if (sat_input < lowlim ) sat_input=lowlim;
  else;
  return sat_input;
}

void pwm_modulate(float pwm_input){ // PWM function
  analogWrite(6,(int)(255-pwm_input*255)); 
}

// This is a PID controller for the voltage

float pidv( float pid_input){
  float e_integration;
  e0v = pid_input;
  e_integration = e0v;
 
  //anti-windup, if last-time pid output reaches the limitation, this time there won't be any intergrations.
  if(u1v >= uv_max) {
    e_integration = 0;
  } else if (u1v <= uv_min) {
    e_integration = 0;
  }

  delta_uv = kpv*(e0v-e1v) + kiv*Ts*e_integration + kdv/Ts*(e0v-2*e1v+e2v); //incremental PID programming avoids integrations.there is another PID program called positional PID.
  u0v = u1v + delta_uv;  //this time's control output

  //output limitation
  saturation(u0v,uv_max,uv_min);
  
  u1v = u0v; //update last time's control output
  e2v = e1v; //update last last time's error
  e1v = e0v; // update last time's error
  return u0v;
}

// This is a PID controller for the current

float pidi(float pid_input){
  float e_integration;
  e0i = pid_input;
  e_integration=e0i;
  
  //anti-windup
  if(u1i >= ui_max){
    e_integration = 0;
  } else if (u1i <= ui_min) {
    e_integration = 0;
  }
  
  delta_ui = kpi*(e0i-e1i) + kii*Ts*e_integration + kdi/Ts*(e0i-2*e1i+e2i); //incremental PID programming avoids integrations.
  u0i = u1i + delta_ui;  //this time's control output

  //output limitation
  saturation(u0i,ui_max,ui_min);
  
  u1i = u0i; //update last time's control output
  e2i = e1i; //update last last time's error
  e1i = e0i; // update last time's error
  return u0i;
}
