ib619/Group7_design_project/Energy_Subsystem/Power/Power.cpp

#include "Power.h"
#include <Arduino.h>

/*

Flow chart (typical)
----------------------
0 > 1 > 2 > 3 > 4 > 1 > 2 > 3 > 4 > ......

0 IDLE
1 CHARGE (yellow LED)
2 CHARGE REST (note: only records charge data after first discharge)
3 SLOW DISCHARGE (250mA)
4 DISCHARGE REST
5 ERROR (red LED)(must go to 0 next and restart)
6 CONSTANT VOLTAGE CHARGE (blinking yellow LED)
7 RECALIBRATION COMPLETE
8 NORMAL DISCHARGE (500mA)
9 RAPID DISCHARGE (1A)
10 RAPID CURRENT CHARGE (500mA)
  Normal discharge (8), rapid discharge (1A) and rapid current charge (500mA) are currently called manually
  In general rapid discharge and rapid current charge is not recommended for long periods.
    Rapid discharge is disabled when SoC is below 30%. Also it is only valid for no more than 10 seconds.
    Rapid charge is disabled when SoC is above 70% 
11 AFTER DISCHARGING AND CHARGING (then send voltage curves and current curves)


Summary of SD csv files
-----------------------
Stats.csv: q1,q2,qq3_now
cv_SoC.csv: V1 V2 V3 SOC
dv_SoC.csv: V1 V2 V3 SOC
thresholds.csv: d_ocv_l_1, d_ocv_u_1, c_ocv_u_1, c_ocv_l_1, (then same for cell 2 and 3, on the same row)


Frequency of recording
----------------------
Recalibration - manual
    Record new discharge and charge voltage values - every 2 minutes
    End of recalibration: send SoH values, as well as current capacity (in terms of charge)
Send SoC info - every half minute


*/

SMPS::SMPS() {};

// NOTE: Also need to load in threshold values
void SMPS::init() {

    /* Need to Initialise
        Current statistics: current maximal charge, determined from last calibration
        Charge discharge curves, from SD
        Cycles
    */

   SoC_1_arr.fill(0);
   SoC_2_arr.fill(0);
   SoC_3_arr.fill(0);

    //Check for the SD Card
    Serial.println("\nInitializing SD card...");
    if (!SD.begin(SD_CS)) {
        Serial.println("* is a card inserted?");
        while (true) {} // Stick here FOREVER if no SD is in on boot
    } else {
        Serial.println("Wiring is correct and a card is present.");
    }

    String content;

    // Current maximal charge, determined from last calibration
    // 3 items in one row: q1_now, q2_now, q3_now. Determins SoC by lookup upon booting up.
    if (SD.exists("Stats.csv")) {
        myFile = SD.open("Stats.csv");  
        if(myFile) {    
            for (int i = 0; i < 2; i++) {
                content = myFile.readStringUntil(',');
                //Serial.println(content);
                if (i == 0) {
                    q1_now = content.toFloat();
                }
                if (i == 1) {
                    q2_now = content.toFloat();
                }
            }
            // Finally
            content = myFile.readStringUntil('\n');
            q3_now = content.toFloat();
        }
    } else {
        Serial.println("Stats File not open");
    }
    myFile.close();
    SoH_1 = q1_now/q1_0*100;
    SoH_2 = q2_now/q2_0*100;
    SoH_3 = q3_now/q3_0*100;

    if (SD.exists("Cycles.csv")) {
        myFile = SD.open("Cycles.csv");  
        if(myFile) {    
            for (int i = 0; i < 2; i++) {
                content = myFile.readStringUntil(',');
                //Serial.println(content);
                if (i == 0) {
                    cycle1 = content.toFloat();
                }
                if (i == 1) {
                    cycle2 = content.toFloat();
                }
            }
            // Finally
            content = myFile.readStringUntil('\n');
            cycle3 = content.toFloat();
        }
    } else {
        Serial.println("Cycles File not open");
    }

    // Initialise discharge and charge tables
    if (SD.exists("dv_SoC.csv")) {
        myFile = SD.open("dv_SoC.csv");
        if (myFile) {
            for (int i = 0; i < 100; i++) {
                content = myFile.readStringUntil(',');
                d_v_1[i] = content.toFloat();
                content = myFile.readStringUntil(',');
                d_v_2[i] = content.toFloat();
                content = myFile.readStringUntil(',');
                d_v_3[i] = content.toFloat();
                content = myFile.readStringUntil('\n');
                d_SoC[i] = content.toFloat();
                /*
                Serial.println(
                    String(d_v_1[i]) + "," + 
                    String(d_v_2[i]) + "," + 
                    String(d_v_3[i]) + "," + 
                    String(d_SoC[i])
                );
                */
                if (content == "") {
                    Serial.println("Insertion Complete");   
                    break; 
                }                 
            }
        }
    } else {
        Serial.println("Discharge File not open");
    }
    myFile.close();

    if (SD.exists("cv_SoC.csv")) {
        myFile = SD.open("cv_SoC.csv");
        if (myFile) {
            for (int i = 0; i < 100; i++) {
                content = myFile.readStringUntil(',');
                c_v_1[i] = content.toFloat();
                content = myFile.readStringUntil(',');
                c_v_2[i] = content.toFloat();
                content = myFile.readStringUntil(',');
                c_v_3[i] = content.toFloat();
                content = myFile.readStringUntil('\n');
                c_SoC[i] = content.toFloat();
                /*
                Serial.println(
                    String(c_v_1[i]) + "," 
                    + String(c_v_2[i]) + "," 
                    + String(c_v_3[i])  + "," 
                    + String(c_SoC[i])
                );
                */
                if (content == "") {
                    Serial.println("Insertion Complete");    
                    break;
                    
                }                 
            }
        }
    } else {
        Serial.println("Charge File not open");
    }
    myFile.close();

    if (SD.exists("drivepwr.csv")) {
        myFile = SD.open("drivepwr.csv");
        if (myFile) {
            for (int i = 0; i < 18; i++) {
                content = myFile.readStringUntil(',');
                drive_speed[i] = content.toFloat();
                content = myFile.readStringUntil('\n');
                drive_power[i] = content.toFloat();
                /*
                Serial.println(
                    String(drive_speed[i]) + "," + String(drive_power[i])
                );
                */
                if (content == "") {
                    Serial.println("Insertion Complete");    
                    break;
                    
                }                 
            }
        }
    } else {
        Serial.println("Drive Pwr File not open");
    }
    myFile.close();
}

void SMPS::triggerError() {
    state = 5;
    error = 1;
}

//TODO: this can be called even if command is running
void SMPS::reset() {
    error = 0;
    state = 0;
    command_running = 0;
}

int SMPS::get_state() {
    return state;
}

void SMPS::decode_command(int cmd, int speed, int pos_x, int pos_y, int drive_status, float V_1, float V_2, float V_3) {
    if (cmd == 0) {
        if (pos_x == 0 && pos_y == 0 || drive_status == 2) {
            charge(); //FIXME: need to do constant charge afterwards, IDLE
        } else {
            determine_discharge_current(cmd, V_1, V_2, V_3);
            if (speed == 0 || drive_status == 0) {        
                stop(); // IDLE
            } else {
                discharge();// discharge
            }
        }
    } else if (cmd == 1) {
        recalibrate_SOH();
    }
}

int SMPS::estimate_range(int x0, int y0, float distance, int drive_status) {
    if ((x0 ==0 && y0 == 0) || drive_status == 2) {
        x0 = 0, y0 = 0;
        return 0;
    } else if ((x0 != 0 || y0 != 0) && (x1 ==0 && y1 == 0)) { // Left charger
        SoC_1_start = SoC_1;
        SoC_2_start = SoC_2;
        SoC_3_start = SoC_3;
    } else if  ((SoC_1_start - SoC_1 > 20) && (SoC_2_start - SoC_2 > 20) & (SoC_3_start - SoC_3 > 20)) {
        //float grossSoCDrop = (SoC_1_start - SoC_1) + (SoC_2_start - SoC_2) + (SoC_3_start - SoC_3);
        //float grossSoC = SoC_1 + SoC_2 + SoC_3;
        //float result = distance_travelled*grossSoC/grossSoCDrop;
        return static_cast<int>(distance* ((SoC_1 + SoC_2 + SoC_3)/(SoC_1_start - SoC_1) + (SoC_2_start - SoC_2) + (SoC_3_start - SoC_3)));     
    }
    x1 = x0, y1 = y0;
}

float SMPS::minimum(float item_1, float item_2, float item_3) {
  if (item_1 <= item_2 && item_1 <= item_3) {
    return item_1;
  }
  if (item_2 <= item_1 && item_2 <= item_3) {
    return item_2;
  }
  if (item_3 <= item_1 && item_3 <= item_1) {
    return item_3;
  }
}

int SMPS::estimate_time(float V_1, float V_2, float V_3) {
    //float amphr_capacity = minimum(SoC_1, SoC_2, SoC_3)*minimum(q1_now, q2_now, q3_now)/100;
    //float remaining_Ws = 3*(V_1+V_2+V_3)/1000 * amphr_capacity; // Voltage in mV
   // Assume idle power is 2W
   // Return in Seconds
   return static_cast<int>(minimum(SoC_1, SoC_2, SoC_3)*minimum(q1_now, q2_now, q3_now)/100 * ((V_1+V_2+V_3)-3*2500)/1000 /2/ 0.8); // From lab results, efficiency is no less than 80%
}

void SMPS::charge() {
    command_running = 1;
    state = 1;
    // will then automatically go on to state 6 then 2.
}

void SMPS::rapid_charge() {
    command_running = 1;
    state = 10;
}

void SMPS::determine_discharge_current(int speed, float V_1, float V_2, float V_3) {
  for (int i=0; i < 18; i++) {
        if (i == 18) {
            discharge_current = -250;
        } else if (speed > drive_speed[i] && speed <= drive_speed[i+1]) {
            Serial.println("Looked up discharge table");
            float drive_power_flt = static_cast<float>(drive_power[i]);
            discharge_current =  -(drive_power_flt/(V_1+V_2+V_3))/0.9; // accounting for inefficiencies
        }
    }
}

float SMPS::get_discharge_current() {
    return discharge_current;
}

void SMPS::discharge() {
    command_running = 1;
    state = 8;
}

void SMPS::rapid_discharge() {
    command_running = 1;
    state = 9;
}

void SMPS::stop() {
    command_running = 0;
    state = 0;
}

void SMPS::recalibrate_SOH() {
    command_running = 1;
    recalibrating = 1;
    c_iterator = 0;
    d_iterator = 0;
}

// q1, q2, q3 will vary because we might use the discharge to divert some of the current
void SMPS::send_current_cap() {
    q1_now = q1;
    q2_now = q2;
    q3_now = q3;

    SoH_1 = q1_now/q1_0*100;
    SoH_2 = q2_now/q2_0*100;
    SoH_3 = q3_now/q3_0*100;

    //NOTE: Also write to SD card first.
    dataString = String(q1_now) + "," + String(q2_now) + "," + String(q3_now);

    if (SD.exists("Stats.csv")) {
        SD.remove("Stats.csv");
    }

    myFile = SD.open("Stats.csv", FILE_WRITE);
    if (myFile){ 
      myFile.println(dataString); 
    } else {
      Serial.println("File not open"); 
    }
    myFile.close();
}

void SMPS::next_cycle() {
    if (q1 > q1_now) {
        q1 = 0;
        cycle1 = cycle1 + 0.5;
        cycle_changed = 1;
    }
    if (q2 > q2_now) {
        q2 = 0;
        cycle2 = cycle2 + 0.5;
        cycle_changed = 1;
    }
    if (q3 > q3_now) {
        q3 = 0;
        cycle3 = cycle3 + 0.5;
        cycle_changed = 1;
    }

    if (cycle_changed == 1){
        dataString = String(cycle1) + "," + String(cycle2) + "," + String(cycle3);

        if (SD.exists("Cycles.csv")) {
            SD.remove("Cycles.csv");
        }

        myFile = SD.open("Cycles.csv", FILE_WRITE);
        if (myFile){ 
            myFile.println(dataString); 
        } else {
            Serial.println("File not open"); 
        }
        myFile.close();
    }
}

int SMPS::get_cycle(int cell_num) {
   if (cell_num == 1) {
    return static_cast<int>(cycle1);
  } else if (cell_num == 2) {
    return static_cast<int>(cycle2);
  } else if (cell_num == 3) {
    return static_cast<int>(cycle3);
  }
  cycle_changed = 0;
}

int SMPS::get_SOH(int cell_num) {
    if (cell_num == 1) {
        return static_cast<int>(SoH_1);
  } else if (cell_num == 2) {
        return static_cast<int>(SoH_2);
  } else if (cell_num == 3) {
        return static_cast<int>(SoH_3);
  }
}

void SMPS::compute_SOC(int state_num, float V_1, float V_2, float V_3) {
    float temp1 = SoC_1;
    float temp2 = SoC_2;
    float temp3 = SoC_3;
    bool lookup = 1;

    if (state_num == 0 && prev_state == -1) {
        temp1 = lookup_c_table(1, V_1, V_2, V_3);
        temp2 = lookup_c_table(2, V_1, V_2, V_3);
        temp3 = lookup_c_table(3, V_1, V_2, V_3);
        Serial.println("Start log");
    } else if (state_num == 0 || state_num == 5 || state_num == 7) { //IDLE
        // LOOKUP for V1, V2, V3
        // FREEZE values, do nothing
    } else if ((state_num == 1 || state_num == 6 || state_num == 10) && prev_state == 0){ // starting Charge
         // LOOKUP for V1, V2, V3
        temp1 = lookup_c_table(1, V_1, V_2, V_3);
        temp2 = lookup_c_table(2, V_1, V_2, V_3);
        temp3 = lookup_c_table(3, V_1, V_2, V_3);
        lookup = 0;
    } else if ((state_num == 3 || state_num == 8 || state_num == 9) && prev_state == 0){ // starting discharge
         // LOOKUP for V1, V2, V3
        temp1 = lookup_d_table(1, V_1, V_2, V_3);
        temp2 = lookup_d_table(2, V_1, V_2, V_3);
        temp3 = lookup_d_table(3, V_1, V_2, V_3);
        lookup = 0;
    } else if (state_num == 1 || state_num == 6 || state_num == 10) { // CHARGE
        if (V_1 > c_ocv_u || V_1 < c_ocv_l) { // LOOKUP        
            temp1 = lookup_c_table(1, V_1, V_2, V_3); 
        } else { // COULOMB COUNTING
            temp1 = temp1 + dq1/q1_now*100;
            lookup = 0;
            Serial.println("CC1");
        }
        if (V_2 > c_ocv_u || V_2 < c_ocv_l) { // LOOKUP
            temp2 = lookup_c_table(2, V_1, V_2, V_3);
        } else { // COULOMB COUNTING  
            temp2 = temp2 + dq2/q2_now*100;
            lookup = 0;
            Serial.println("CC2");
        }
        if (V_3 > c_ocv_u || V_3 < c_ocv_l) { // LOOKUP  
            temp3 = lookup_c_table(3, V_1, V_2, V_3);          
        } else { // COULOMB COUNTING
            temp3 = temp3 + dq3/q3_now*100;
            lookup = 0;
            Serial.println("CC3");
        }
    } else if (state_num == 3 || state_num == 8 || state_num == 9) { // DISCHARGE
        if (V_1 > d_ocv_u || V_1 < d_ocv_l) { // LOOKUP
            temp1 = lookup_d_table(1, V_1, V_2, V_3);
        } else { // COULOMB COUNTING
            temp1 = temp1 + dq1/q1_now*100;
            lookup = 0;
            Serial.println("CC1");
        }
        if (V_2 > d_ocv_u || V_2 < d_ocv_l) { // LOOKUP           
            temp2 = lookup_d_table(2, V_1, V_2, V_3);
        } else { // COULOMB COUNTING
            temp2 = temp2 + dq2/q2_now*100;
            lookup = 0;
            Serial.println("CC2");
        }
        if (V_3 > d_ocv_u || V_3 < d_ocv_l) { // LOOKUP
            temp3 = lookup_d_table(3, V_1, V_2, V_3);
        } else { // COULOMB COUNTING
            temp3 = temp3 + dq3/q3_now*100;
            lookup = 0;
            Serial.println("CC3");
        }
    } else if (state_num == 2) {
        temp1 = 100;
        temp2 = 100;
        temp3 = 100;
    } else if (state_num == 4) {
        temp1 = 0;
        temp2 = 0;
        temp3 = 0;
    }

    if (arr_size < 60) { // If Moving average filter is not full yet
      float sum1 = 0, sum2 = 0, sum3 = 0;
      if (arr_size > 5) { // Should ignore first 5 values
        SoC_1_arr.push(temp1);
        SoC_2_arr.push(temp2);
        SoC_3_arr.push(temp3);
        if (lookup == 1) {
          for (int i = 0; i < arr_size + 1 - 5; i++) {
             sum1 = sum1 + SoC_1_arr[i];
             sum2 = sum2 + SoC_2_arr[i];
             sum3 = sum3 + SoC_3_arr[i];
          }
          SoC_1 = sum1/(arr_size + 1 - 5);
          SoC_2 = sum2/(arr_size + 1 - 5);
          SoC_3 = sum3/(arr_size + 1 - 5);
        } else { // Do not get moving average filter value for colomb count
          SoC_1 = temp1;
          SoC_2 = temp2;
          SoC_3 = temp3;
          Serial.println("Not moving average");
        }      
      } else { // Do not push into filter for first 5 values
        SoC_1 = temp1;
        SoC_2 = temp2;
        SoC_3 = temp3;
      }
      arr_size = arr_size + 1;     
    } else { // In most cases
      if (lookup == 1) {
        SoC_1_arr.push(temp1);
        SoC_2_arr.push(temp2);
        SoC_3_arr.push(temp3);
        SoC_1 = SoC_1_arr.get();
        SoC_2 = SoC_2_arr.get();
        SoC_3 = SoC_3_arr.get();
      } else {
        SoC_1 = temp1;
        SoC_2 = temp2;
        SoC_3 = temp3;
        SoC_1_arr.push(temp1); // just push into FIFO, but not taking the moving average value
        SoC_2_arr.push(temp2);
        SoC_3_arr.push(temp3);
        Serial.println("Not moving average");
      }       
    }

     //Assign previous state
    prev_state = state_num;
    dq1 = 0; dq2 = 0; dq3 = 0;
    next_cycle();
}

int SMPS::get_SOC(int cell_num) {
  if (cell_num == 1) {
    return static_cast<int>(SoC_1);
  } else if (cell_num == 2) {
    return static_cast<int>(SoC_2);
  } else if (cell_num == 3) {
    return static_cast<int>(SoC_3);
  }
}

float SMPS::lookup_c_table(int cell_num, float V_1, float V_2, float V_3) {
    if (cell_num == 1) {
        for (int i=0; i < 100; i++) {
            if (i == 99) {
                return 1.0;
            } else if (V_1 >= c_v_1[i] && V_1 < c_v_1[i+1]) {
                Serial.println("Looked up charge table");
                return c_SoC[i];
            }
        }
    } else if (cell_num == 2) {
        for (int i=0; i < 100; i++) {
            if (i == 99) {
                return 1.0;
            } else if (V_2 >= c_v_2[i] && V_2 < c_v_2[i+1]) {
                Serial.println("Looked up charge table");
                return c_SoC[i];
            }
        }
    } else if (cell_num == 3) {
        for (int i=0; i < 100; i++) {
            if (i == 99) {
                return 1.0;
            } else if (V_3 >= c_v_3[i] && V_3 < c_v_3[i+1]) {
                Serial.println("Looked up charge table");
                return c_SoC[i];
            }
        }
    }  
}

float SMPS::lookup_d_table(int cell_num, float V_1, float V_2, float V_3) {
    //NOTE: changed to less than equal to operator
    if (cell_num == 1) {
        for (int i=0; i < 100; i++) {
            if (i == 99) {
                return 0.0;
            } else if (V_1 <= d_v_1[i] && V_1 > d_v_1[i+1]) {
                Serial.println("Looked up discharge table");
                return d_SoC[i];
            }
        }
    } else if (cell_num == 2) {
        for (int i=0; i < 100; i++) {
            if (i == 99) {
                return 0.0;
            } else if (V_2 <= d_v_2[i] && V_2 > d_v_2[i+1]) {
                Serial.println("Looked up discharge table");
                return d_SoC[i];
            }
        }
    } else if (cell_num == 3) {
        for (int i=0; i < 100; i++) {
            if (i == 99) {
                return 0.0;
            } else if (V_3 <= d_v_3[i] && V_3 > d_v_3[i+1]) {
                Serial.println("Looked up discharge table");
                return d_SoC[i];
            }
        }
    }
}

void SMPS::clear_lookup() {
    // Clear lookup table on SD
    if (SD.exists("dv_SoC.csv")) {
        SD.remove("dv_SoC.csv");
    }
    if (SD.exists("cv_SoC.csv")) {
        SD.remove("cv_SoC.csv");
    }

    // Erase Tables
    memset(d_v_1, 0, sizeof(d_v_1));
    memset(c_v_1, 0, sizeof(c_v_1));
    memset(d_v_2, 0, sizeof(d_v_2));
    memset(c_v_2, 0, sizeof(c_v_2));
    memset(d_v_3, 0, sizeof(d_v_3));
    memset(c_v_3, 0, sizeof(c_v_3));
}

//TODO: clear tables before recording curves (before recalibration)
void SMPS::record_curve(int state_num, float V_1, float V_2, float V_3) {
    // Decide thresholds after evaluating entire table
    dataString = String(V_1) + "," + String(V_2) + "," + String(V_3);

    if (state_num == 1 || state_num == 2 || state_num == 6) {
        myFile = SD.open("cv.csv", FILE_WRITE); // only for backup
        c_v_1[c_iterator] = V_1;
        c_v_2[c_iterator] = V_2;
        c_v_3[c_iterator] = V_3;
    } else if (state_num == 3 || state_num == 4) {
        myFile = SD.open("dv.csv", FILE_WRITE); // only for backup
        d_v_1[d_iterator] = V_1;
        d_v_2[d_iterator] = V_2;
        d_v_3[d_iterator] = V_3;
    }

    if (myFile) {
        myFile.println(dataString);
    }
    myFile.close();
    d_iterator = d_iterator + 1;
    c_iterator = c_iterator + 1;
}

void SMPS::create_SoC_table() {
    float d_SoC_1 = 100;
    float c_SoC_1 = 0;

    float d_size = static_cast<float>(d_iterator);
    float c_size = static_cast<float>(c_iterator);

    // Erase Tables
    memset(d_SoC, 0, sizeof(d_SoC));
    memset(c_SoC, 0, sizeof(c_SoC));

    //Need to erase file first. Not the same for SoH file, which keeps the entire battery history
    if (SD.exists("dv_SoC.csv")) {
        SD.remove("dv_SoC.csv");
    }
    myFile = SD.open("dv_SoC.csv", FILE_WRITE);
    for(int i = 0; i < d_iterator; i++){
        if (i == d_iterator - 1) {
            dataString = String(d_v_1[i]) + "," + String(d_v_2[i]) + "," + String(d_v_3[i]) + "," + String(0);
        } else {
            dataString = String(d_v_1[i]) + "," + String(d_v_2[i]) + "," + String(d_v_3[i]) + "," + String(d_SoC_1);
        }    
        // Serial.println(dataString);
        myFile.println(dataString);
        d_SoC[i] = d_SoC_1; // insert value into array
        d_SoC_1 = d_SoC_1 - 1/d_size*100;
    }
    myFile.close();

    if (SD.exists("cv_SoC.csv")) {
        SD.remove("cv_SoC.csv");
    }
    myFile = SD.open("cv_SoC.csv", FILE_WRITE);
    for(int i = 0; i < c_iterator; i++){
        if (i == c_iterator - 1) {
            dataString = String(c_v_1[i]) + "," + String(c_v_2[i]) + "," + String(c_v_3[i]) + "," + String(100);
        } else {
            dataString = String(c_v_1[i]) + "," + String(c_v_2[i]) + "," + String(c_v_3[i]) + "," + String(c_SoC_1);      
        }
        // Serial.println(dataString);
        myFile.println(dataString);
        c_SoC[i] = c_SoC_1; // insert value into array
        c_SoC_1 = c_SoC_1 + 1/c_size*100;
    }
    myFile.close();

}

void SMPS::charge_discharge(float current_measure) {
    dq1 = dq1 + current_measure/1000.0;
    dq2 = dq2 + current_measure/1000.0;
    dq3 = dq3 + current_measure/1000.0;

    if (relay_on == 1) {
      dq1 = dq1*0.87;
      dq2 = dq2*0.87;
      dq3 = dq3*0.87;
      relay_on = 0;
    }

    q1 = q1 + dq1;
    q2 = q2 + dq2;
    q3 = q3 + dq3;
}

void SMPS::charge_balance(float V_1, float V_2, float V_3, float current_measure) {
    if ((SoC_2 - SoC_1) > 5  && (SoC_3 - SoC_1) > 5) {  // Cell 1 Lowest
        Serial.println("Cell 1 lowest");
        disc1 = 1, disc2 = 0, disc3 = 0;
        dq1 = dq1 + (current_measure - V_1/150.0)/1000.0;
        dq2 = dq2 + current_measure/1000.0;
        dq3 = dq3 + current_measure/1000.0;
    } else if ((SoC_1 - SoC_2) > 5 && (SoC_3 - SoC_2) > 5) { // Cell 2 Lowest
        Serial.println("Cell 2 lowest");
        disc1 = 0, disc2 = 1, disc3 = 0;
        dq1 = dq1 + current_measure/1000.0;
        dq2 = dq2 + (current_measure - V_2/150.0)/1000.0;
        dq3 = dq3 + current_measure/1000.0;
    } else if ((SoC_1 - SoC_3) > 5 && (SoC_2 - SoC_3) > 5) { // Cell 3 Lowest
        Serial.println("Cell 3 lowest");
        disc1 = 0, disc2 = 0, disc3 = 1;
        dq1 = dq1 + current_measure/1000.0;
        dq2 = dq2 + current_measure/1000.0;
        dq3 = dq3 + (current_measure - V_3/150.0)/1000.0;
    } else {
        Serial.println("No balancing");
        disc1 = 0, disc2 = 0, disc3 = 0;
        dq1 = dq1 + current_measure/1000.0;
        dq2 = dq2 + current_measure/1000.0;
        dq3 = dq3 + current_measure/1000.0;
    }
    digitalWrite(PIN_DISC1, disc1);
    digitalWrite(PIN_DISC2, disc2);
    digitalWrite(PIN_DISC3, disc3);

    // The current is halted for a while when the relay is on.
    if (relay_on == 1) {
      dq1 = dq1*0.87;
      dq2 = dq2*0.87;
      dq3 = dq3*0.87;
      relay_on = 0;
    }

    q1 = q1 + dq1;
    q2 = q2 + dq2;
    q3 = q3 + dq3;
}

void SMPS::discharge_balance(float V_1, float V_2, float V_3, float current_measure) {
    if ((SoC_2 - SoC_1) > 5  && (SoC_3 - SoC_1) > 5) {  // Cell 1 Lowest
        Serial.println("Cell 1 lowest");
        disc1 = 1, disc2 = 0, disc3 = 0;
        dq1 = dq1 + (current_measure - V_1/150.0)/1000.0;
        dq2 = dq2 + current_measure/1000.0;
        dq3 = dq3 + current_measure/1000.0;
    } else if ((SoC_1 - SoC_2) > 5 && (SoC_3 - SoC_2) > 5) { // Cell 2 Lowest
        Serial.println("Cell 2 lowest");
        disc1 = 0, disc2 = 1, disc3 = 0;
        dq1 = dq1 + current_measure/1000.0;
        dq2 = dq2 + (current_measure - V_2/150.0)/1000.0;
        dq3 = dq3 + current_measure/1000.0;
    } else if ((SoC_1 - SoC_3) > 5 && (SoC_2 - SoC_3) > 5) { // Cell 3 Lowest
        Serial.println("Cell 3 lowest");
        disc1 = 0, disc2 = 0, disc3 = 1;
        dq1 = dq1 + current_measure/1000.0;
        dq2 = dq2 + current_measure/1000.0;
        dq3 = dq3 + (current_measure - V_3/150.0)/1000.0;
    } else {
        Serial.println("No balancing");
        disc1 = 0, disc2 = 0, disc3 = 0;
        dq1 = dq1 + current_measure/1000.0;
        dq2 = dq2 + current_measure/1000.0;
        dq3 = dq3 + current_measure/1000.0;
    }
    digitalWrite(PIN_DISC1, disc1);
    digitalWrite(PIN_DISC2, disc2);
    digitalWrite(PIN_DISC3, disc3);

    // The current is halted for a while when the relay is on.
    if (relay_on == 1) {
      dq1 = dq1*0.87;
      dq2 = dq2*0.87;
      dq3 = dq3*0.87;
      relay_on = 0;
    }

    q1 = q1 + dq1;
    q2 = q2 + dq2;
    q3 = q3 + dq3;
}

/*
//NOTE: Save thresholds onto Stats.csv
float SMPS::determine_cv_threshold() {
    int iterator = 0;
    for (int i = 0; i < c_iterator-1; i++) {
        if (c_v_1[i+1] - c_v_1[i] < 0.12 * 120 && c_v_1[i] < 3300) {
            c_ocv_l_1 = c_v_1[i];
            iterator = i;
            break;
        }
    }
    for (int i = iterator; i < c_iterator-1; i++) {
        if (c_v_1[i+1] - c_v_1[i] > 0.1 * 120 && c_v_1[i] > 3400) {
            c_ocv_u_1 = c_v_1[i];          
            break;
        }
    }

    iterator = 0;
    for (int i = 0; i < c_iterator-1; i++) {
        if (c_v_2[i+1] - c_v_2[i] < 0.12 * 120 && c_v_2[i] < 3300) {
            c_ocv_l_2 = c_v_2[i];
            iterator = i;
            break;
        }
    }
    for (int i = iterator; i < c_iterator-1; i++) {
        if (c_v_2[i+1] - c_v_2[i] > 0.1 * 120 && c_v_2[i] > 3400) {
            c_ocv_u_2 = c_v_2[i];          
            break;
        }
    }

    iterator = 0;
    for (int i = 0; i < c_iterator-1; i++) {
        if (c_v_3[i+1] - c_v_3[i] < 0.12 * 120 && c_v_3[i] < 3300) {
            c_ocv_l_3 = c_v_3[i];
            iterator = i;
            break;
        }
    }
    for (int i = iterator; i < c_iterator-1; i++) {
        if (c_v_3[i+1] - c_v_3[i] > 0.1 * 120 && c_v_3[i] > 3400) {
            c_ocv_u_3 = c_v_3[i];          
            break;
        }
    }
}

float SMPS::determine_dv_threshold() {
    int iterator = 0;
    for (int i = 0; i < d_iterator-1; i++) {
        if (d_v_1[i+1] - d_v_1[i] > -0.12 * 120 && d_v_1[i] > 3200) {
            d_ocv_u_1 = d_v_1[i];
            iterator = i;
            break;
        }
    }
    for (int i = iterator; i < d_iterator-1; i++) {
        if (d_v_1[i+1] - d_v_1[i] < - 0.08 * 120 && d_v_1[i] < 3100) {
            d_ocv_u_1 = d_v_1[i];          
            break;
        }
    }
    
    iterator = 0;
    for (int i = 0; i < d_iterator-1; i++) {
        if (d_v_2[i+1] - d_v_2[i] > -0.12 * 120 && d_v_2[i] > 3200) {
            d_ocv_u_2 = d_v_2[i];
            iterator = i;
            break;
        }
    }
    for (int i = iterator; i < d_iterator-1; i++) {
        if (d_v_2[i+1] - d_v_2[i] < - 0.08 * 120 && d_v_2[i] < 3100) {
            d_ocv_u_2 = d_v_2[i];          
            break;
        }
    }

    iterator = 0;
    for (int i = 0; i < d_iterator-1; i++) {
        if (d_v_3[i+1] - d_v_3[i] > -0.12 * 120 && d_v_3[i] > 3200) {
            d_ocv_u_3 = d_v_3[i];
            break;
        }
    }
    for (int i = iterator; i < d_iterator-1; i++) {
        if (d_v_3[i+1] - d_v_3[i] < - 0.08 * 120 && d_v_3[i] < 3100) {
            d_ocv_u_3 = d_v_3[i];          
            break;
        }
    }
}
*/
