ib619/Group7_design_project/Vision_Subsystem/DE10_LITE_D8M_VIP_16/ip/EEE_IMGPROC/morph_filters/morph_dilation_filter3x3.v

module morph_dilation_filter3x3 (
    input clk,
    input rst_n,
    input i_pixel,
    input i_pixel_valid, // Both in_valid and packet video
    output o_convolved_data
);


//separableconvolution3x3_dilation #(.DATA_WIDTH(1)) filter(
//    .clk(clk),
//    .rst_n(rst_n),
//    .i_pixel(i_pixel),
//    .i_pixel_valid(i_pixel_valid),
//    .o_pixel(o_convolved_data)
//);

convolution3x3_dilation #(.DATA_WIDTH(1)) filter(
    .clk(clk),
    .rst_n(rst_n),
    .i_pixel(i_pixel),
    .i_pixel_valid(i_pixel_valid),
    .o_pixel(o_convolved_data)
);

endmodule
