ib619/Group7_design_project/Vision_Subsystem/DE10_LITE_D8M_VIP_16/ip/EEE_IMGPROC/perspective_transform/greybox_tmp/greybox_tmp/mgegm.v

//lpm_divide CBX_SINGLE_OUTPUT_FILE="ON" LPM_DREPRESENTATION="SIGNED" LPM_HINT="LPM_REMAINDERPOSITIVE=TRUE" LPM_NREPRESENTATION="SIGNED" LPM_PIPELINE=1 LPM_TYPE="LPM_DIVIDE" LPM_WIDTHD=24 LPM_WIDTHN=28 aclr clock denom numer quotient remain
//VERSION_BEGIN 16.1 cbx_mgl 2016:10:24:15:05:03:SJ cbx_stratixii 2016:10:24:15:04:16:SJ cbx_util_mgl 2016:10:24:15:04:16:SJ  VERSION_END
// synthesis VERILOG_INPUT_VERSION VERILOG_2001
// altera message_off 10463



// Copyright (C) 2016  Intel Corporation. All rights reserved.
//  Your use of Intel Corporation's design tools, logic functions 
//  and other software and tools, and its AMPP partner logic 
//  functions, and any output files from any of the foregoing 
//  (including device programming or simulation files), and any 
//  associated documentation or information are expressly subject 
//  to the terms and conditions of the Intel Program License 
//  Subscription Agreement, the Intel Quartus Prime License Agreement,
//  the Intel MegaCore Function License Agreement, or other 
//  applicable license agreement, including, without limitation, 
//  that your use is for the sole purpose of programming logic 
//  devices manufactured by Intel and sold by Intel or its 
//  authorized distributors.  Please refer to the applicable 
//  agreement for further details.



//synthesis_resources = lpm_divide 1 
//synopsys translate_off
`timescale 1 ps / 1 ps
//synopsys translate_on
module  mgegm
	( 
	aclr,
	clock,
	denom,
	numer,
	quotient,
	remain) /* synthesis synthesis_clearbox=1 */;
	input   aclr;
	input   clock;
	input   [23:0]  denom;
	input   [27:0]  numer;
	output   [27:0]  quotient;
	output   [23:0]  remain;

	wire  [27:0]   wire_mgl_prim1_quotient;
	wire  [23:0]   wire_mgl_prim1_remain;

	lpm_divide   mgl_prim1
	( 
	.aclr(aclr),
	.clock(clock),
	.denom(denom),
	.numer(numer),
	.quotient(wire_mgl_prim1_quotient),
	.remain(wire_mgl_prim1_remain));
	defparam
		mgl_prim1.lpm_drepresentation = "SIGNED",
		mgl_prim1.lpm_nrepresentation = "SIGNED",
		mgl_prim1.lpm_pipeline = 1,
		mgl_prim1.lpm_type = "LPM_DIVIDE",
		mgl_prim1.lpm_widthd = 24,
		mgl_prim1.lpm_widthn = 28,
		mgl_prim1.lpm_hint = "LPM_REMAINDERPOSITIVE=TRUE";
	assign
		quotient = wire_mgl_prim1_quotient,
		remain = wire_mgl_prim1_remain;
endmodule //mgegm
//VALID FILE
