ib619/Group7_design_project/Vision_Subsystem/DE10_LITE_D8M_VIP_16/software/D8M_Cam_v3/esp_link.h

#ifndef ESP_LINK_API_H
#define ESP_LINK_API_H

#include "alt_types.h"  // alt_u32
#include "io.h"

void updateColour(alt_32 base_address, alt_8 detected, alt_16 x_coord_adj, alt_16 y_coord_adj, alt_8 colour);

#endif
