ib619/Group7_design_project/Vision_Subsystem/DE10_LITE_D8M_VIP_16/ip/EEE_IMGPROC/median_filter/comparator.v

module comparator(
	input [DATA_WIDTH - 1:0] pixel0,
	input [DATA_WIDTH - 1:0] pixel1, 
	output [DATA_WIDTH - 1:0] high, 
	output [DATA_WIDTH - 1:0] low
);

parameter DATA_WIDTH = 8;

assign high = (pixel0 >= pixel1) ? pixel0 : pixel1;
assign low = (pixel0 >= pixel1) ? pixel1 : pixel0;

endmodule
