ib619/Group7_design_project/Vision_Subsystem/DE10_LITE_D8M_VIP_16/ip/EEE_IMGPROC/colour_threshold/valid_buffer_inst.v

valid_buffer	valid_buffer_inst (
	.aclr ( aclr_sig ),
	.clken ( clken_sig ),
	.clock ( clock_sig ),
	.shiftin ( shiftin_sig ),
	.shiftout ( shiftout_sig ),
	.taps0x ( taps0x_sig ),
	.taps1x ( taps1x_sig )
	);
