ib619/Group7_design_project/Vision_Subsystem/DE10_LITE_D8M_VIP_16/ip/EEE_IMGPROC/STREAM_REG.v

module STREAM_REG(ready_out, valid_out, data_out, ready_in, valid_in, data_in, clk, rst_n);

	// Input Port(s)
	input clk, rst_n;
	input ready_in, valid_in;
	input [DATA_WIDTH-1:0] data_in;
	
	// Output Port(s)
	output ready_out, valid_out;
	output reg [DATA_WIDTH-1:0] data_out;

	// Parameter Declaration(s)
	parameter DATA_WIDTH = 26;
	
	reg data_valid, ready_in_d;

	always@(posedge clk) begin
		if (~rst_n) begin
			data_out <= 1'b0;
			data_valid <= 0;
			ready_in_d <= 0;
			end
		else begin
			ready_in_d <= ready_in;
			if (valid_in & (~data_valid | ready_in_d)) begin
				data_out <= data_in;
				data_valid <= 1;
				end
			else if (ready_in_d) begin
				data_valid <= 0;
				end
			end
	end
	

	assign ready_out = (~data_valid & ~valid_in) | ready_in; // Send upstream ready only when downstream is ready or when nothing has been loaded into data out
	assign valid_out = ready_in_d & data_valid; // Only assert valid out high if data is valid and ready has been asserted one cycle before

endmodule
