ib619/Group7_design_project/Drive_Subsystem/Anti-Drift/API/Orientation.h

#ifndef ORIENTATION_H
#define ORIENTATION_H

#include <Arduino.h>

struct Position {
    float x;
    float y;
};

class Direction {
    public:
        float x;
        float y;
        float getMagnitude();
};

class Orientation {
public:
    Orientation();
    void updatePosition(int x, int y, bool FW, bool BW, bool CW, bool ACW); //updates the position of the rover
    void updateDirection(); //updates the direction of the rover, needs to be called after updatePosition()
    void logOrientation(); //logs Orientation data to Serial for debug
    void enableLog(); //enables logging for debug 
    void disableLog(); //disables logging gor debug
    void logRotation(); // logs the type of motion performed by the rover for debug
    float getTravelDistance();
    float getDirectionChangeAngle();

    int exportPositionX(); //export current X coordinate for control subsystem
    int exportPositionY(); //export current Y coordinate for control subsystem
    int exportDirectionAngle(); //export the angle between initial and current rover direction
    int exportTotalRun(); //export total distance travelled since the start of the rover

    // four following methods are needed to interface Orientation and Drive APIs for T2C algorithm
    float passPosX(); 
    float passPosY();
    float passDirX();
    float passDirY();

    bool position_changed = 0; //indicates if there was a position change since last loop cycle

private:
    int radius = 168;
    int rotation;
    int total_distance_travelled = 0;
    bool log_enable = 0;
    bool enable_direction_update = 0;
    Position truePosition;
    Position lastPosition; 
    Position currentPosition;
    Direction lastDirection;
    Direction currentDirection;
    Direction displacement;
    Direction initial;
    void detectRotation(); //detects which type of motion has been performed by rover
    void getDisplacement(); //calculates displacement since last loop cycle
     

};

#endif
