ib619/Group7_design_project/Vision_Subsystem/DE10_LITE_D8M_VIP_16/ip/EEE_IMGPROC/morph_filter2.v

module morph_filter2 (
	input clk,
	input rst_n,
	input i_pixel,
	input i_pixel_valid, // Both in_valid and packet video
	output o_convolved_data
);

wire [8:0] pre_filter;

convolution2 #(.DATA_WIDTH(1)) filter(
	.clk(clk),
	.rst_n(rst_n),
	.i_pixel(i_pixel),
	.i_pixel_valid(i_pixel_valid),
	.o_pixel(pre_filter)
);


erosion erosion_filter(
	.i_pixel(pre_filter),
	.o_convolved_data(o_convolved_data)
);

endmodule
