ib619/Group7_design_project/Control_Subsystem/Control_program/control_program/config_template.h

#ifndef CONTROL_CONFIG_H
#define CONTROL_CONFIG_H

// copy this file and name it as "config.h" and save it in the same directory

#define WIFI_SSID "[your wifi name]"
#define WIFI_PASSWORD "[your wifi password]"

#define MQTT_SERVER "[IP Address or domain name of MQTT broker]"
#define MQTT_PORT 1883  // MQTT server port (default is 1883)

#define MQTT_USER "siting"  // is a beast
#define MQTT_PASSWORD "password"    // default

#endif
