ib619/Group7_design_project/Vision_Subsystem/testing/morph_filter/erosion/db/erosion_filter_tb.smp_dump.txt

State Machine - |convolution3x3_erosion|state
Name state.FILTER_ON 
state.START_UP 0 
state.FILTER_ON 1 
