ib619/Group7_design_project/Drive_Subsystem/Arduino_Code/ESP32_Command_Simulation.ino

#include "DriveInterface.h"

#define waitInterval 50

DriveInterface di(&Serial1);

int mDrive_Mode = 0;
int mDistance = 0;
int mSpeed = 0;
int mDirection = 0;
int mX = 0;
int mY = 0;

int rover_heading = 0;
int alert = 0;
int axisX = 0;
int axisY = 0;
unsigned long totRun = 0;

void setup() {
  di.setBaudrate(115200);
  di.begin();
  Serial.begin(115200);
  Serial.setTimeout(5);
}

void loop() {

  //Command: drive_mode,distance,speed,direction,target_x,target_y
 
 if (Serial.available())
  {
    char message[30];
    int amount = Serial.readBytesUntil(';', message, 30);
    message[amount] = NULL;

    int data[10];
    int count = 0;
    char* offset = message;
    while (true)
    {
      data[count++] = atoi(offset);
      offset = strchr(offset, ',');
      if (offset) offset++;
      else break;
    }

    mDrive_Mode = data[0];
    mDistance = data[1];
    mSpeed = data[2];
    mDirection = data[3];
    mX = data[4];
    mY = data[5];
    
    di.writeDriveMode(mDrive_Mode);
    di.writeDistance(mDistance);
    di.writeSpeed(mSpeed);
    di.writeDirection(mDirection);
    di.writeTargetX(mX);
    di.writeTargetY(mY);
    di.sendUpdates();
  }

  if(di.fetchData())  {
    rover_heading = di.getRoverHeading();  //fetch new direction value
    alert = di.getAlert();  //fetch new speed value
    axisX = di.getAxisX();  // fetch new distance value
    axisY = di.getAxisY(); //fetch new drive mode value
    totRun = di.getTotalDistance();

    Serial.println("Heading: " + String(rover_heading));
    Serial.println("Alert: " + String(alert));
    Serial.println("X: " + String(axisX));
    Serial.println("Y: " + String(axisY));
    Serial.println("Total Distance: " + String(totRun));
    Serial.println(" ");

  }
}
