ib619/Group7_design_project/Vision_Subsystem/DE10_LITE_D8M_VIP_16/software/D8M_Camera_Test_bsp/system.h

/*
 * system.h - SOPC Builder system and BSP software package information
 *
 * Machine generated for CPU 'nios2_gen2' in SOPC Builder design 'Qsys'
 * SOPC Builder design path: ../../Qsys.sopcinfo
 *
 * Generated: Tue Jun 15 22:34:41 BST 2021
 */

/*
 * DO NOT MODIFY THIS FILE
 *
 * Changing this file will have subtle consequences
 * which will almost certainly lead to a nonfunctioning
 * system. If you do modify this file, be aware that your
 * changes will be overwritten and lost when this file
 * is generated again.
 *
 * DO NOT MODIFY THIS FILE
 */

/*
 * License Agreement
 *
 * Copyright (c) 2008
 * Altera Corporation, San Jose, California, USA.
 * All rights reserved.
 *
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
 * This agreement shall be governed in all respects by the laws of the State
 * of California and by the laws of the United States of America.
 */

#ifndef __SYSTEM_H_
#define __SYSTEM_H_

/* Include definitions from linker script generator */
#include "linker.h"


/*
 * CPU configuration
 *
 */

#define ALT_CPU_ARCHITECTURE "altera_nios2_gen2"
#define ALT_CPU_BIG_ENDIAN 0
#define ALT_CPU_BREAK_ADDR 0x00041820
#define ALT_CPU_CPU_ARCH_NIOS2_R1
#define ALT_CPU_CPU_FREQ 50000000u
#define ALT_CPU_CPU_ID_SIZE 1
#define ALT_CPU_CPU_ID_VALUE 0x00000000
#define ALT_CPU_CPU_IMPLEMENTATION "fast"
#define ALT_CPU_DATA_ADDR_WIDTH 0x13
#define ALT_CPU_DCACHE_BYPASS_MASK 0x80000000
#define ALT_CPU_DCACHE_LINE_SIZE 32
#define ALT_CPU_DCACHE_LINE_SIZE_LOG2 5
#define ALT_CPU_DCACHE_SIZE 2048
#define ALT_CPU_EXCEPTION_ADDR 0x00020020
#define ALT_CPU_FLASH_ACCELERATOR_LINES 0
#define ALT_CPU_FLASH_ACCELERATOR_LINE_SIZE 0
#define ALT_CPU_FLUSHDA_SUPPORTED
#define ALT_CPU_FREQ 50000000
#define ALT_CPU_HARDWARE_DIVIDE_PRESENT 0
#define ALT_CPU_HARDWARE_MULTIPLY_PRESENT 1
#define ALT_CPU_HARDWARE_MULX_PRESENT 0
#define ALT_CPU_HAS_DEBUG_CORE 1
#define ALT_CPU_HAS_DEBUG_STUB
#define ALT_CPU_HAS_EXTRA_EXCEPTION_INFO
#define ALT_CPU_HAS_ILLEGAL_INSTRUCTION_EXCEPTION
#define ALT_CPU_HAS_JMPI_INSTRUCTION
#define ALT_CPU_ICACHE_LINE_SIZE 32
#define ALT_CPU_ICACHE_LINE_SIZE_LOG2 5
#define ALT_CPU_ICACHE_SIZE 4096
#define ALT_CPU_INITDA_SUPPORTED
#define ALT_CPU_INST_ADDR_WIDTH 0x13
#define ALT_CPU_NAME "nios2_gen2"
#define ALT_CPU_NUM_OF_SHADOW_REG_SETS 0
#define ALT_CPU_OCI_VERSION 1
#define ALT_CPU_RESET_ADDR 0x00020000


/*
 * CPU configuration (with legacy prefix - don't use these anymore)
 *
 */

#define NIOS2_BIG_ENDIAN 0
#define NIOS2_BREAK_ADDR 0x00041820
#define NIOS2_CPU_ARCH_NIOS2_R1
#define NIOS2_CPU_FREQ 50000000u
#define NIOS2_CPU_ID_SIZE 1
#define NIOS2_CPU_ID_VALUE 0x00000000
#define NIOS2_CPU_IMPLEMENTATION "fast"
#define NIOS2_DATA_ADDR_WIDTH 0x13
#define NIOS2_DCACHE_BYPASS_MASK 0x80000000
#define NIOS2_DCACHE_LINE_SIZE 32
#define NIOS2_DCACHE_LINE_SIZE_LOG2 5
#define NIOS2_DCACHE_SIZE 2048
#define NIOS2_EXCEPTION_ADDR 0x00020020
#define NIOS2_FLASH_ACCELERATOR_LINES 0
#define NIOS2_FLASH_ACCELERATOR_LINE_SIZE 0
#define NIOS2_FLUSHDA_SUPPORTED
#define NIOS2_HARDWARE_DIVIDE_PRESENT 0
#define NIOS2_HARDWARE_MULTIPLY_PRESENT 1
#define NIOS2_HARDWARE_MULX_PRESENT 0
#define NIOS2_HAS_DEBUG_CORE 1
#define NIOS2_HAS_DEBUG_STUB
#define NIOS2_HAS_EXTRA_EXCEPTION_INFO
#define NIOS2_HAS_ILLEGAL_INSTRUCTION_EXCEPTION
#define NIOS2_HAS_JMPI_INSTRUCTION
#define NIOS2_ICACHE_LINE_SIZE 32
#define NIOS2_ICACHE_LINE_SIZE_LOG2 5
#define NIOS2_ICACHE_SIZE 4096
#define NIOS2_INITDA_SUPPORTED
#define NIOS2_INST_ADDR_WIDTH 0x13
#define NIOS2_NUM_OF_SHADOW_REG_SETS 0
#define NIOS2_OCI_VERSION 1
#define NIOS2_RESET_ADDR 0x00020000


/*
 * Define for each module class mastered by the CPU
 *
 */

#define __ALTERA_AVALON_JTAG_UART
#define __ALTERA_AVALON_ONCHIP_MEMORY2
#define __ALTERA_AVALON_PIO
#define __ALTERA_AVALON_SYSID_QSYS
#define __ALTERA_AVALON_TIMER
#define __ALTERA_NIOS2_GEN2
#define __ALTPLL
#define __EEE_IMGPROC
#define __I2C_OPENCORES
#define __TERASIC_AUTO_FOCUS


/*
 * EEE_IMGPROC_0 configuration
 *
 */

#define ALT_MODULE_CLASS_EEE_IMGPROC_0 EEE_IMGPROC
#define EEE_IMGPROC_0_BASE 0x42000
#define EEE_IMGPROC_0_IRQ -1
#define EEE_IMGPROC_0_IRQ_INTERRUPT_CONTROLLER_ID -1
#define EEE_IMGPROC_0_NAME "/dev/EEE_IMGPROC_0"
#define EEE_IMGPROC_0_SPAN 32
#define EEE_IMGPROC_0_TYPE "EEE_IMGPROC"


/*
 * System configuration
 *
 */

#define ALT_DEVICE_FAMILY "MAX 10"
#define ALT_ENHANCED_INTERRUPT_API_PRESENT
#define ALT_IRQ_BASE NULL
#define ALT_LOG_PORT "/dev/null"
#define ALT_LOG_PORT_BASE 0x0
#define ALT_LOG_PORT_DEV null
#define ALT_LOG_PORT_TYPE ""
#define ALT_NUM_EXTERNAL_INTERRUPT_CONTROLLERS 0
#define ALT_NUM_INTERNAL_INTERRUPT_CONTROLLERS 1
#define ALT_NUM_INTERRUPT_CONTROLLERS 1
#define ALT_STDERR "/dev/jtag_uart"
#define ALT_STDERR_BASE 0x420f8
#define ALT_STDERR_DEV jtag_uart
#define ALT_STDERR_IS_JTAG_UART
#define ALT_STDERR_PRESENT
#define ALT_STDERR_TYPE "altera_avalon_jtag_uart"
#define ALT_STDIN "/dev/jtag_uart"
#define ALT_STDIN_BASE 0x420f8
#define ALT_STDIN_DEV jtag_uart
#define ALT_STDIN_IS_JTAG_UART
#define ALT_STDIN_PRESENT
#define ALT_STDIN_TYPE "altera_avalon_jtag_uart"
#define ALT_STDOUT "/dev/jtag_uart"
#define ALT_STDOUT_BASE 0x420f8
#define ALT_STDOUT_DEV jtag_uart
#define ALT_STDOUT_IS_JTAG_UART
#define ALT_STDOUT_PRESENT
#define ALT_STDOUT_TYPE "altera_avalon_jtag_uart"
#define ALT_SYSTEM_NAME "Qsys"


/*
 * TERASIC_AUTO_FOCUS_0 configuration
 *
 */

#define ALT_MODULE_CLASS_TERASIC_AUTO_FOCUS_0 TERASIC_AUTO_FOCUS
#define TERASIC_AUTO_FOCUS_0_BASE 0x42040
#define TERASIC_AUTO_FOCUS_0_IRQ -1
#define TERASIC_AUTO_FOCUS_0_IRQ_INTERRUPT_CONTROLLER_ID -1
#define TERASIC_AUTO_FOCUS_0_NAME "/dev/TERASIC_AUTO_FOCUS_0"
#define TERASIC_AUTO_FOCUS_0_SPAN 32
#define TERASIC_AUTO_FOCUS_0_TYPE "TERASIC_AUTO_FOCUS"


/*
 * altpll_0 configuration
 *
 */

#define ALTPLL_0_BASE 0x420e0
#define ALTPLL_0_IRQ -1
#define ALTPLL_0_IRQ_INTERRUPT_CONTROLLER_ID -1
#define ALTPLL_0_NAME "/dev/altpll_0"
#define ALTPLL_0_SPAN 16
#define ALTPLL_0_TYPE "altpll"
#define ALT_MODULE_CLASS_altpll_0 altpll


/*
 * data_mem configuration
 *
 */

#define ALT_MODULE_CLASS_data_mem altera_avalon_onchip_memory2
#define DATA_MEM_ALLOW_IN_SYSTEM_MEMORY_CONTENT_EDITOR 0
#define DATA_MEM_ALLOW_MRAM_SIM_CONTENTS_ONLY_FILE 0
#define DATA_MEM_BASE 0x40000
#define DATA_MEM_CONTENTS_INFO ""
#define DATA_MEM_DUAL_PORT 1
#define DATA_MEM_GUI_RAM_BLOCK_TYPE "AUTO"
#define DATA_MEM_INIT_CONTENTS_FILE "Qsys_data_mem"
#define DATA_MEM_INIT_MEM_CONTENT 0
#define DATA_MEM_INSTANCE_ID "NONE"
#define DATA_MEM_IRQ -1
#define DATA_MEM_IRQ_INTERRUPT_CONTROLLER_ID -1
#define DATA_MEM_NAME "/dev/data_mem"
#define DATA_MEM_NON_DEFAULT_INIT_FILE_ENABLED 0
#define DATA_MEM_RAM_BLOCK_TYPE "AUTO"
#define DATA_MEM_READ_DURING_WRITE_MODE "DONT_CARE"
#define DATA_MEM_SINGLE_CLOCK_OP 0
#define DATA_MEM_SIZE_MULTIPLE 1
#define DATA_MEM_SIZE_VALUE 1024
#define DATA_MEM_SPAN 1024
#define DATA_MEM_TYPE "altera_avalon_onchip_memory2"
#define DATA_MEM_WRITABLE 1


/*
 * hal configuration
 *
 */

#define ALT_INCLUDE_INSTRUCTION_RELATED_EXCEPTION_API
#define ALT_MAX_FD 32
#define ALT_SYS_CLK TIMER
#define ALT_TIMESTAMP_CLK none


/*
 * i2c_opencores_camera configuration
 *
 */

#define ALT_MODULE_CLASS_i2c_opencores_camera i2c_opencores
#define I2C_OPENCORES_CAMERA_BASE 0x42060
#define I2C_OPENCORES_CAMERA_IRQ 1
#define I2C_OPENCORES_CAMERA_IRQ_INTERRUPT_CONTROLLER_ID 0
#define I2C_OPENCORES_CAMERA_NAME "/dev/i2c_opencores_camera"
#define I2C_OPENCORES_CAMERA_SPAN 32
#define I2C_OPENCORES_CAMERA_TYPE "i2c_opencores"


/*
 * i2c_opencores_mipi configuration
 *
 */

#define ALT_MODULE_CLASS_i2c_opencores_mipi i2c_opencores
#define I2C_OPENCORES_MIPI_BASE 0x42080
#define I2C_OPENCORES_MIPI_IRQ 0
#define I2C_OPENCORES_MIPI_IRQ_INTERRUPT_CONTROLLER_ID 0
#define I2C_OPENCORES_MIPI_NAME "/dev/i2c_opencores_mipi"
#define I2C_OPENCORES_MIPI_SPAN 32
#define I2C_OPENCORES_MIPI_TYPE "i2c_opencores"


/*
 * jtag_uart configuration
 *
 */

#define ALT_MODULE_CLASS_jtag_uart altera_avalon_jtag_uart
#define JTAG_UART_BASE 0x420f8
#define JTAG_UART_IRQ 2
#define JTAG_UART_IRQ_INTERRUPT_CONTROLLER_ID 0
#define JTAG_UART_NAME "/dev/jtag_uart"
#define JTAG_UART_READ_DEPTH 64
#define JTAG_UART_READ_THRESHOLD 8
#define JTAG_UART_SPAN 8
#define JTAG_UART_TYPE "altera_avalon_jtag_uart"
#define JTAG_UART_WRITE_DEPTH 64
#define JTAG_UART_WRITE_THRESHOLD 8


/*
 * key configuration
 *
 */

#define ALT_MODULE_CLASS_key altera_avalon_pio
#define KEY_BASE 0x420c0
#define KEY_BIT_CLEARING_EDGE_REGISTER 0
#define KEY_BIT_MODIFYING_OUTPUT_REGISTER 0
#define KEY_CAPTURE 0
#define KEY_DATA_WIDTH 2
#define KEY_DO_TEST_BENCH_WIRING 0
#define KEY_DRIVEN_SIM_VALUE 0
#define KEY_EDGE_TYPE "NONE"
#define KEY_FREQ 50000000
#define KEY_HAS_IN 1
#define KEY_HAS_OUT 0
#define KEY_HAS_TRI 0
#define KEY_IRQ -1
#define KEY_IRQ_INTERRUPT_CONTROLLER_ID -1
#define KEY_IRQ_TYPE "NONE"
#define KEY_NAME "/dev/key"
#define KEY_RESET_VALUE 0
#define KEY_SPAN 16
#define KEY_TYPE "altera_avalon_pio"


/*
 * mipi_pwdn_n configuration
 *
 */

#define ALT_MODULE_CLASS_mipi_pwdn_n altera_avalon_pio
#define MIPI_PWDN_N_BASE 0x420a0
#define MIPI_PWDN_N_BIT_CLEARING_EDGE_REGISTER 0
#define MIPI_PWDN_N_BIT_MODIFYING_OUTPUT_REGISTER 0
#define MIPI_PWDN_N_CAPTURE 0
#define MIPI_PWDN_N_DATA_WIDTH 1
#define MIPI_PWDN_N_DO_TEST_BENCH_WIRING 0
#define MIPI_PWDN_N_DRIVEN_SIM_VALUE 0
#define MIPI_PWDN_N_EDGE_TYPE "NONE"
#define MIPI_PWDN_N_FREQ 50000000
#define MIPI_PWDN_N_HAS_IN 0
#define MIPI_PWDN_N_HAS_OUT 1
#define MIPI_PWDN_N_HAS_TRI 0
#define MIPI_PWDN_N_IRQ -1
#define MIPI_PWDN_N_IRQ_INTERRUPT_CONTROLLER_ID -1
#define MIPI_PWDN_N_IRQ_TYPE "NONE"
#define MIPI_PWDN_N_NAME "/dev/mipi_pwdn_n"
#define MIPI_PWDN_N_RESET_VALUE 0
#define MIPI_PWDN_N_SPAN 16
#define MIPI_PWDN_N_TYPE "altera_avalon_pio"


/*
 * mipi_reset_n configuration
 *
 */

#define ALT_MODULE_CLASS_mipi_reset_n altera_avalon_pio
#define MIPI_RESET_N_BASE 0x420b0
#define MIPI_RESET_N_BIT_CLEARING_EDGE_REGISTER 0
#define MIPI_RESET_N_BIT_MODIFYING_OUTPUT_REGISTER 0
#define MIPI_RESET_N_CAPTURE 0
#define MIPI_RESET_N_DATA_WIDTH 1
#define MIPI_RESET_N_DO_TEST_BENCH_WIRING 0
#define MIPI_RESET_N_DRIVEN_SIM_VALUE 0
#define MIPI_RESET_N_EDGE_TYPE "NONE"
#define MIPI_RESET_N_FREQ 50000000
#define MIPI_RESET_N_HAS_IN 0
#define MIPI_RESET_N_HAS_OUT 1
#define MIPI_RESET_N_HAS_TRI 0
#define MIPI_RESET_N_IRQ -1
#define MIPI_RESET_N_IRQ_INTERRUPT_CONTROLLER_ID -1
#define MIPI_RESET_N_IRQ_TYPE "NONE"
#define MIPI_RESET_N_NAME "/dev/mipi_reset_n"
#define MIPI_RESET_N_RESET_VALUE 0
#define MIPI_RESET_N_SPAN 16
#define MIPI_RESET_N_TYPE "altera_avalon_pio"


/*
 * onchip_memory2_0 configuration
 *
 */

#define ALT_MODULE_CLASS_onchip_memory2_0 altera_avalon_onchip_memory2
#define ONCHIP_MEMORY2_0_ALLOW_IN_SYSTEM_MEMORY_CONTENT_EDITOR 0
#define ONCHIP_MEMORY2_0_ALLOW_MRAM_SIM_CONTENTS_ONLY_FILE 0
#define ONCHIP_MEMORY2_0_BASE 0x20000
#define ONCHIP_MEMORY2_0_CONTENTS_INFO ""
#define ONCHIP_MEMORY2_0_DUAL_PORT 0
#define ONCHIP_MEMORY2_0_GUI_RAM_BLOCK_TYPE "AUTO"
#define ONCHIP_MEMORY2_0_INIT_CONTENTS_FILE "Qsys_onchip_memory2_0"
#define ONCHIP_MEMORY2_0_INIT_MEM_CONTENT 0
#define ONCHIP_MEMORY2_0_INSTANCE_ID "NONE"
#define ONCHIP_MEMORY2_0_IRQ -1
#define ONCHIP_MEMORY2_0_IRQ_INTERRUPT_CONTROLLER_ID -1
#define ONCHIP_MEMORY2_0_NAME "/dev/onchip_memory2_0"
#define ONCHIP_MEMORY2_0_NON_DEFAULT_INIT_FILE_ENABLED 0
#define ONCHIP_MEMORY2_0_RAM_BLOCK_TYPE "AUTO"
#define ONCHIP_MEMORY2_0_READ_DURING_WRITE_MODE "DONT_CARE"
#define ONCHIP_MEMORY2_0_SINGLE_CLOCK_OP 0
#define ONCHIP_MEMORY2_0_SIZE_MULTIPLE 1
#define ONCHIP_MEMORY2_0_SIZE_VALUE 100000
#define ONCHIP_MEMORY2_0_SPAN 100000
#define ONCHIP_MEMORY2_0_TYPE "altera_avalon_onchip_memory2"
#define ONCHIP_MEMORY2_0_WRITABLE 1


/*
 * sw configuration
 *
 */

#define ALT_MODULE_CLASS_sw altera_avalon_pio
#define SW_BASE 0x420d0
#define SW_BIT_CLEARING_EDGE_REGISTER 0
#define SW_BIT_MODIFYING_OUTPUT_REGISTER 0
#define SW_CAPTURE 0
#define SW_DATA_WIDTH 10
#define SW_DO_TEST_BENCH_WIRING 0
#define SW_DRIVEN_SIM_VALUE 0
#define SW_EDGE_TYPE "NONE"
#define SW_FREQ 50000000
#define SW_HAS_IN 1
#define SW_HAS_OUT 0
#define SW_HAS_TRI 0
#define SW_IRQ -1
#define SW_IRQ_INTERRUPT_CONTROLLER_ID -1
#define SW_IRQ_TYPE "NONE"
#define SW_NAME "/dev/sw"
#define SW_RESET_VALUE 0
#define SW_SPAN 16
#define SW_TYPE "altera_avalon_pio"


/*
 * sysid_qsys configuration
 *
 */

#define ALT_MODULE_CLASS_sysid_qsys altera_avalon_sysid_qsys
#define SYSID_QSYS_BASE 0x420f0
#define SYSID_QSYS_ID 0
#define SYSID_QSYS_IRQ -1
#define SYSID_QSYS_IRQ_INTERRUPT_CONTROLLER_ID -1
#define SYSID_QSYS_NAME "/dev/sysid_qsys"
#define SYSID_QSYS_SPAN 8
#define SYSID_QSYS_TIMESTAMP 1623792112
#define SYSID_QSYS_TYPE "altera_avalon_sysid_qsys"


/*
 * timer configuration
 *
 */

#define ALT_MODULE_CLASS_timer altera_avalon_timer
#define TIMER_ALWAYS_RUN 0
#define TIMER_BASE 0x42020
#define TIMER_COUNTER_SIZE 32
#define TIMER_FIXED_PERIOD 0
#define TIMER_FREQ 50000000
#define TIMER_IRQ 3
#define TIMER_IRQ_INTERRUPT_CONTROLLER_ID 0
#define TIMER_LOAD_VALUE 49999
#define TIMER_MULT 0.001
#define TIMER_NAME "/dev/timer"
#define TIMER_PERIOD 1
#define TIMER_PERIOD_UNITS "ms"
#define TIMER_RESET_OUTPUT 0
#define TIMER_SNAPSHOT 1
#define TIMER_SPAN 32
#define TIMER_TICKS_PER_SEC 1000
#define TIMER_TIMEOUT_PULSE_OUTPUT 0
#define TIMER_TYPE "altera_avalon_timer"

#endif /* __SYSTEM_H_ */
