ib619/Group7_design_project/Vision_Subsystem/testing/morph_filter/erosion/erosion_filter_tb.v

`timescale 1 ns/10 ps  // time-unit = 1 ns, precision = 10 ps


module erosion_filter_tb(
);
    reg clk;
    reg rst_n;
    reg i_pixel;
    wire o_convolved_data;
	 wire tap0;
	 wire tap1;
	 wire pixelEnable_check;
 	 wire [8:0] pixelCounter1;
 	 wire [3:0] pixelRowCounter1;
	 wire [4:0] pixelStartUpCounter_check;
	 
    reg i_valid;
//	 wire o_valid;
    localparam period = 20; 
	 integer i;

    // Clock Generation
    always 
    begin
        clk = 1'b1; 
        #20; // high for 20 * timescale = 20 ns

        clk = 1'b0;
        #20; // low for 20 * timescale = 20 ns
    end

    // Testing
    initial begin
	 	  rst_n = 1'b0;
        i_valid = 1'b0;
		  i_pixel = 0;
		  
		  @(posedge clk)
		  rst_n = 1'b1;
        i_valid = 1'b1;
		  #1;
		  
        
		  // 000000000
		  // 000011000
		  // 001100000
		  // 011110000
		  // 011110010
		  // 001100000
		  
			// First Row
		  for (i = 0; i < 9; i=i+1)
		  begin
		      @(posedge clk)
				#1;
				i_pixel = 0;
				#2;
            $display("Convolved Data Output=%d", o_convolved_data);

		  end
			
			// Second Row
		  for (i = 0; i < 4; i=i+1)
		  begin
		      @(posedge clk)
				#1;
				i_pixel = 0;
				#2;
            $display("Convolved Data Output=%d", o_convolved_data);

		  end
		  for (i = 0; i < 2; i=i+1)
		  begin
		      @(posedge clk)
				#1;
				i_pixel = 1;
				#2;
            $display("Convolved Data Output=%d", o_convolved_data);

		  end
		  for (i = 0; i < 3; i=i+1)
		  begin
		      @(posedge clk)
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
			.o_pixel(o_convolved_data),
			.pixelCounter1(pixelCounter1),
 	      .pixelRowCounter1(pixelRowCounter1),
			.pixelStartUpCounter_check(pixelStartUpCounter_check),
			.pixelEnable_check(pixelEnable_check),
		   .tap0(tap0),
		   .tap1(tap1)
			
		);
		
endmodule
