ib619/Group7_design_project/(commit log)

2021-05-17 added library for arduino to ESP32 interface
2021-05-17 Attempt to Implement PnO and Cell Balancing
    And fix some syntax errors
    [Battery_Balancing_Attempt.ino, PnO_Attempt_Implementation.ino]
2021-05-18 New incremental conductance algorithm (not preferred)
    Also added research notes for PV panels and batteries.
    [Couple Relevant Data c951c3ae95f34b7c8ca7476f6547319b.csv, Data Table 7e34b73d0088425a82d25aca824f3ff2.csv]
2021-05-18 updated arduino-ESP32 interface API
2021-05-19 Added ESP32 Settings for Arduino IDE
2021-05-20 adding vision gaussian blur hsv threshold pipeline
    [DE10_LITE_D8M_VIP.smp_dump.txt]
2021-05-20 vision now can communicate to esp32
    [DE10_LITE_D8M_VIP.smp_dump.txt]
2021-05-20 added API for FPGA-ESP32 interface
2021-05-20 added Orientation arduino files
2021-05-21 Upload Test Files
    Battery charge and discharge curves
    Cell balancing in parallel mode
    Recalibrating SoH for a single cell
    MATLAB file to plot battery cycles
    [BATCYCLE1.CSV, BATCYCLE2.CSV, BATCYCLE3.CSV, BATCYCLE4.CSV, BATCYCLE5.CSV]
2021-05-21 Documentation updates and new charge profile
    [BATCYCLE6_CCCV.CSV]
2021-05-21 upload drive system pin usage
2021-05-24 adding erosion filter
    [DE10_LITE_D8M_VIP.smp_dump.txt]
2021-05-24 update Arduino_Code
2021-05-25 Implement Power.h Power.cpp Methods and Create Master Arduino File
2021-05-25 updated Arduino-ESP32 Interface library
2021-05-26 update: Arduino_Code
2021-05-27 Reorganise file structure and rewrite test scripts
    [BATCYCLE1.CSV, BATCYCLE2.CSV, BATCYCLE3.CSV, BATCYCLE4.CSV, BATCYCLE5.CSV, BATCYCLE6_CCCV.CSV, Couple Relevant Data c951c3ae95f34b7c8ca7476f6547319b.csv, Data Table 7e34b73d0088425a82d25aca824f3ff2.csv]
2021-05-27 sorting out repo
    [DE10_LITE_D8M_VIP.smp_dump.txt]
2021-05-27 added erosion control switch and used a more efficient convolution
2021-05-27 update: API/Arduino_Code ver 1.9
2021-05-27 added auto brightness adjust and new morph filter
    [greyscale.csv, stp1.stp]
2021-05-28 Re-test 1 PV <--> 1 Cell operation
    [CELL1TEST1.CSV]
2021-05-28 Adjust interrupts and decrease resolution for lookup table
    [CELL1TEST2.CSV, CELL1TEST3.CSV]
2021-05-29 Fixed syntax errors
    [CELL1TEST4.CSV, CELL1TEST5.CSV]
2021-05-29 fixed negative numbers in Drive-ESP32 API libraries
    [ControlInterface.cpp, DriveInterface.cpp]
2021-05-30 added reset button
2021-05-30 Single Cell Single PV Test
    [CELL1TEST1.CSV, CELL1TEST2.CSV, CELL1TEST3.CSV, CELL1TEST4.CSV, CELL1TEST5.CSV]
2021-05-30 erosion and dilation filter multiple bbox
    [greyscale.csv]
2021-05-31 added ESP32 API support for FPGA LEDs
2021-06-01 Sweeping IV curve with voltage
    [SWEEPNO.CSV, SWEEPNO2.CSV]
2021-06-01 update: Anti-Drift ver 1.0
    [Anti_Drift_PID.ino, Drive.cpp, Drive.h, Orientation.cpp, Orientation.h]
2021-06-02 updated ESP32 control_program
2021-06-02 added Drive_Power_Data
    [Drive_Power_Data.xlsx]
2021-06-02 update: Anti-Drift ver 1.1
    [Drive.cpp, Drive.h]
2021-06-02 added LED indicators to control_program
2021-06-02 added reset support to Control
    [ControlInterface.cpp, ControlInterface.h, DriveInterface.cpp, DriveInterface.h, RoverFunctions.cpp, RoverFunctions.h, control_program.ino]
2021-06-02 added new Energy-ESP32 interface
2021-06-03 New SoC Estimation Method
    [BATCYCLE.CSV, BATCYCLE2.CSV, DIAGNOSE.CSV, DIAGNOSE2.CSV]
2021-06-03 added median filter and corrected software nios2
    [EEE_IMGPROC.v, Qsys.v, Qsys_bb.v, Qsys_inst.v, Qsys_inst.vhd, Qsys_sysid_qsys.v]
2021-06-04 Master File Updated
    [BATCYCLE.CSV, BATCYCLE2.CSV, BATCYCLE3.CSV, DIAGNOSE.CSV, DIAGNOSE2.CSV, DIAGNOSE3.CSV, cv_SoC.csv, dv_SoC.csv]
2021-06-04 led debug code
2021-06-04 reset now sets drive_mode to 0
    [control_program.ino]
2021-06-05 Sweeping duty cycle and voltage for PV
    [BATCYCLE2.CSV, DIAGNOSE2.CSV, PVCELLDT.CSV, PVCELLDT_LampOff.CSV, PVPWMSWE.CSV, PVPWMSWE.csv, PVPWMSWE_Test2.CSV, SWEEPNO.CSV]
2021-06-05 Images for Report
    [DIAGNOSE.CSV, MPPT_PVC.CSV, SWEEPNO.CSV, SWEEPNO2.CSV]
2021-06-05 added battery components
2021-06-06 multiPV charging
2021-06-07 perspective transform
    [greyscale.csv]
2021-06-07 reworked FPGA-ESP32 interface
2021-06-07 fixed FPGA data fetch
    [FPGAInterface.cpp, RoverFunctions.cpp, control_program.ino, fpga_api_dev.ino]
2021-06-07 unlocked obstacle avoidance routine
    [RoverFunctions.cpp, RoverFunctions.h, control_program.ino]
2021-06-08 updated python script for parsing stuff from arduino
    [STATS.csv, drivepwr.csv]
2021-06-08 arduino python interface serial input
2021-06-08 updated obstacle avoidance routine
    [control_program.ino]
2021-06-09 Completed Energy Demo File
    [Control_Demo.xlsx, DIAGNOSE3.CSV, charge_demo.csv, discharge_demo.csv]
2021-06-09 Updated Demo file to reflect drop in range
    [Control_Demo.xlsx, charge_demo.csv, discharge_demo.csv]
2021-06-09 additional demo file
    [Control_Demo.xlsx, charge_demo2.csv, discharge_demo2.csv]
2021-06-09 updated obstacle avoidance speed to 250
    [control_program.ino]
2021-06-10 update map and battery
2021-06-10 send stop command once for obstacle avoidance
    [control_program.ino]
2021-06-10 changed obstacle threshold to 50cm
2021-06-10 Serial issues
    [4SeriesPV_Test1.csv, 4SeriesPV_Test2.CSV, 4SeriesPV_Test3.CSV, 4_parallelcells_test1.CSV, 4_parallelcells_test2.CSV, 4_parallelcells_test3.CSV, 4_seriesPV_test4_newresistorconfig.csv, 4_seriesPV_test5_newresistorconfig.CSV]
2021-06-11 Added error states, time and cycle to demo file
    [Control_Demo.xlsx, Cycles.csv, charge_demo2.csv, discharge_demo2.csv, drivepwr.csv]
2021-06-11 Here comes the sun!
    [4SeriesPV_Test4_newresistorconfig.csv, 4SeriesPV_Test5_newresistorconfig.CSV, 4SeriesPV_Test6_home.CSV, 4SeriesPV_Test7_home.CSV, 4_parallelcells_test4_home.CSV, 4_parallelcells_test5_home.CSV, 4_parallelcells_test6_home.CSV, PVCELLS.CSV]
2021-06-12 Demo file not incorporates actual PV panels!!!
    [charge_demo.csv, discharge_demo.csv]
2021-06-12 add battery return to base alert
2021-06-14 adding testbenches
    [gaussian_filter_tb.smp_dump.txt]
2021-06-14 Tidying up Master File
    [Control_Demo.xlsx, Drive_Power_Data.xlsx, charge_demo2.csv, charge_demo3.csv, discharge_demo2.csv, discharge_demo3.csv]
2021-06-15 Made comments in Test Files
    [Couple Relevant Data c951c3ae95f34b7c8ca7476f6547319b.csv, DIAGNOSE.CSV, Data Table 7e34b73d0088425a82d25aca824f3ff2.csv, MPPT_PVC.CSV]
2021-06-15 sorting this mess
    [dilation_filter_tb.smp_dump.txt]
2021-06-15 sorting more mess
    [erosion_filter_tb.smp_dump.txt]
